hujjika1099-glitch/Repo/reports/final_release/TICKET_028_FINAL_PROJECT_CLOSURE_SUMMARY.md

# TICKET 028 - Final Project Closure Summary

## Fecha

2026-05-11

## Commit base

`032a3fb`

## Decision final

- `PROJECT_FUNCTIONAL_COMPLETE = YES`
- `PROTOTYPE_RELEASE_CANDIDATE_READY = YES`
- `BAQUELADA_REVA_FUNCTIONAL_VALIDATED_BY_EXPERT = YES`
- `BAQUELADA_REVA_ACCEPTED_FOR_PROTOTYPE_USE = YES`
- `PRODUCTION_MANUFACTURING_PACKAGE_READY = NO`
- `REPOSITORY_FINAL_STATE_READY = YES`

## Cambios realizados

- README y AGENTS actualizados al estado final.
- Node map actualizado a release candidate funcional.
- Configuracion RevA actualizada a validacion funcional experta.
- Decisiones fisicas cerradas para uso de prototipo RevA por validacion experta.
- Config final del proyecto creada.
- Documentos finales de cierre, release candidate y handover creados.
- Documentacion tecnica, cliente y baquelada actualizada.
- Validador final creado.

## Baquelada RevA

- Estado: `functional_validated_by_expert`.
- Uso: aceptada para prototipo.
- Rol: nodo sensor KX134 repetido para Sensor 1 y Sensor 2.
- Receptor: sin baquelada, conectado directamente al PC.
- Artefactos registrados: PDF y SVG bajo `hardware/pcb/baquelada_revA/artifacts/`.

## Alcance de manufactura

El prototipo funcional queda cerrado. La fabricacion industrial repetible no se
declara lista porque requeriria DFM, BOM final, Gerbers, fixture y QA de
manufactura si el cliente lo solicita.

## Advertencias no bloqueantes

- Icono corporativo pendiente.
- Firma digital pendiente.
- Scaling Windows 125/150 pendiente.
- `sample_rate_hz` GUI -> firmware pendiente.
- DFM/BOM/Gerbers/QA pendientes solo si se requiere fabricacion repetible.

## Validaciones ejecutadas

- `python -m py_compile tools\kx134\validate_final_project_state.py`
- `python tools\kx134\validate_final_project_state.py --output reports\final_release\TICKET_028_final_project_state_output.json` -> PASS
- JSON tool sobre configs y output final.
- Unit tests KX134 y app launcher.
- Verificaciones git de rutas restringidas.

## Referencias historicas restantes

La busqueda de estado anterior conserva referencias en documentos historicos de
tickets previos y en documentos no editados en TICKET 028. No aparecen como
estado actual en README, AGENTS, node_map, config final, docs finales ni docs de
baquelada actualizados.
