hujjika1099-glitch/Repo/docs/kx134_migration/REQUIREMENTS_BASELINE.md

# Baseline de requisitos KX134

## Sensores y identidad

- El sistema debe trabajar con dos sensores SparkFun SEN-17589 / KX134.
- El sistema debe usar tres ESP32 totales:
  - ESP32 sensora 1.
  - ESP32 sensora 2.
  - ESP32 receptora.
- Cada ESP32 sensora debe tener un solo SEN-17589/KX134 asociado.
- `sensor_id=1` y `sensor_id=2` son obligatorios.
- No se debe inferir `sensor_id` por defecto si falta en el stream.
- Cada sensor fisico debe tener asociacion estable:
  - `sensor_id` logico.
  - Etiqueta fisica visible.
  - ESP32 asociada.
  - MAC de la ESP32.
  - Rol dentro del sistema.
  - Archivo de calibracion individual.

## Calibracion

- La calibracion individual es obligatoria antes de pruebas de prototipo.
- Cada sensor debe tener su propio `calibration_id`.
- No se debe reutilizar calibracion entre sensores.

## Datos KX134

- Exportar datos crudos digitales por eje:
  - `x_raw`
  - `y_raw`
  - `z_raw`
- Exportar conversion basica a `g`:
  - `x_g`
  - `y_g`
  - `z_g`
- No incluir columnas de voltaje para KX134:
  - No `mv_x`
  - No `mv_y`
  - No `mv_z`
- La aplicacion no debe hacer analisis profundo. Debe capturar, convertir
  basicamente a `g`, prechequear integridad y exportar evidencia.

## Captura y sincronizacion

- La sincronizacion entre ambos sensores es requisito central.
- Debe existir precheck dual antes de aceptar capturas operativas.
- Los archivos futuros deben incluir campos de sincronizacion:
  - `sensor_id`
  - `node_mac`
  - `seq`
  - `sensor_t_us`
  - `receiver_t_us`
  - `pc_wall_s`
  - `sample_rate_hz`
  - `range_g`
  - `calibration_id`

## Parametros operativos futuros

- La duracion de captura debe ser editable manualmente en segundos.
- La duracion debe aceptar valores positivos arbitrarios, por ejemplo `10` o
  `1567`.
- La frecuencia de muestreo debe ser seleccionable.
- Frecuencias permitidas:
  - `100 Hz`
  - `200 Hz`
  - `400 Hz`
  - `800 Hz`
- La frecuencia default debe ser `100 Hz`.
- La opcion `800 Hz` debe validarse en firmware/libreria KX134 y puede
  requerir modo High-Performance.

## GUI y empaquetado futuros

- La GUI debe ser adaptable, profesional y clara para captura dual.
- La GUI debe exponer duracion manual y frecuencia seleccionable.
- El empaquetado Windows debe conservar la ruta de salida junto al ejecutable.
- El empaquetado Windows debe incorporar DPI awareness en tickets posteriores.

## Topologia base

- Arquitectura cerrada:
  - Dos ESP32 sensoras independientes.
  - Una ESP32 receptora.
  - Dos sensores SEN-17589/KX134.
  - Un KX134 por ESP32 sensora.
- La comunicacion de nodos sensores a receptor sera ESP-NOW.
- La ESP32 receptora enviara datos a la aplicacion por Serial USB.
- Esta arquitectura conserva el flujo conceptual actual del repositorio:
  nodos sensores -> ESP-NOW -> receptor -> Serial USB -> aplicacion.
- No se usara arquitectura de solo dos ESP32 ni una sola ESP32 leyendo dos
  sensores en esta fase, salvo decision futura explicita.
