hujjika1099-glitch/Repo/hardware/pcb/baquelada_revA/BAQUELADA_REVA_REVIEW.md

# Revision visual - Baquelada RevA

## Artefactos revisados

- `hardware/pcb/baquelada_revA/artifacts/Maestria.PDF`
- `hardware/pcb/baquelada_revA/artifacts/Maestria.SVG`

## Observaciones visuales

- Exportacion generada por Proteus Design Suite.
- Placa rectangular segun SVG.
- Dimensiones declaradas por SVG: 90.49 mm x 44.99 mm.
- Se observan pistas gruesas en negro.
- Se observan pads circulares/laterales conectados por pistas.
- Se observan dos zonas tipo hileras de pads/header.
- No se observan nombres de net en el fragmento SVG inspeccionado.
- No se observa serigrafia funcional visible.
- No se observan marcas claras de orientacion X/Y/Z.
- No se observan labels 3V3/GND/SDA/SCL.
- No se observa layer/mirror explicito.
- No se observa netlist ni DRC formal asociado.
- No se declaran taladros como especificacion mecanica separada en la documentacion registrada.

## Riesgos

- Escala de impresion incorrecta.
- Mirror incorrecto.
- Confusion entre capa superior e inferior.
- Pinout no validado contra ESP32/KX134.
- Falta de labels 3V3/GND/SDA/SCL.
- Posible corto por puentes de transferencia.
- Posible desalineacion de headers.
- Falta de montaje mecanico.
- Falta de strain relief.
- Falta de confirmacion de diametro de taladro.
- Falta de netlist/DRC formal.

## Decision visual

- `BAQUELADA_REVA_VISUAL_REVIEW = PASS_WITH_WARNINGS_CLOSED_BY_EXPERT_FUNCTIONAL_VALIDATION`
- `BAQUELADA_REVA_FUNCTIONAL_VALIDATED_BY_EXPERT = YES`
- `BAQUELADA_REVA_ACCEPTED_FOR_PROTOTYPE_USE = YES`

Justificacion: PDF/SVG quedan como artefactos registrados; la funcionalidad final fue validada por el experto del proyecto. No se genera paquete DFM/BOM/Gerbers/QA de manufactura en este cierre.

## Cierre Final TICKET 028

- `PROJECT_FUNCTIONAL_COMPLETE = YES`
- `PROTOTYPE_RELEASE_CANDIDATE_READY = YES`
- `BAQUELADA_REVA_FUNCTIONAL_VALIDATED_BY_EXPERT = YES`
- `BAQUELADA_REVA_ACCEPTED_FOR_PROTOTYPE_USE = YES`
- `PRODUCTION_MANUFACTURING_PACKAGE_READY = NO`

La baquelada RevA fue completada fisicamente y validada como funcional por el experto del proyecto. Queda aceptada para uso de prototipo KX134 Sensor 1/Sensor 2. Esto no constituye paquete de fabricacion industrial repetible; si el cliente lo requiere, faltan DFM, BOM final, Gerbers y QA de manufactura.
