hujjika1099-glitch/Repo/docs/kx134_migration/pcb/PCB_PRE_DESIGN_REVIEW.md

# Revision previa antes de esquematico/layout PCB KX134

No iniciar esquematico, layout, Gerber ni BOM final hasta cerrar esta lista.

- [ ] Alimentacion final cerrada.
- [ ] Tension/corriente cerradas.
- [ ] Proteccion contra inversion/sobrecorriente definida.
- [ ] Conectores cerrados.
- [ ] Longitudes cerradas.
- [ ] Tipo de cable cerrado.
- [ ] Alivio de tension definido.
- [ ] Montaje cerrado.
- [ ] Orientacion de ejes cerrada.
- [ ] Ubicacion receptor cerrada.
- [ ] Ubicacion Sensor 1 cerrada.
- [ ] Ubicacion Sensor 2 cerrada.
- [ ] Caja/carcasa definida.
- [ ] Acceso a USB/BOOT/EN definido.
- [ ] Etiquetas fisicas definidas.
- [ ] Recalibracion prevista si cambia fisica.
- [ ] Cliente aprueba dimensiones.
- [ ] Cliente aprueba cableado.
- [ ] Cliente aprueba estetica.
- [ ] Validar si se mantiene 100 Hz / 8 g.
- [ ] Validar si se requiere 200/400/800 Hz.
- [ ] Validar si se requiere configuracion `sample_rate_hz` desde GUI.

## Decision actual

- `PCB_PHYSICAL_DECISIONS_COMPLETE = NO`
- `PCB_DESIGN_AUTHORIZED = NO`
