hujjika1099-glitch/Repo/reports/kx134_gui_validation/TICKET_016_hw_capture_20260510_123052/reports/analysis_outputs/kx134_dual_live/kx134_dual_live_ticket016_hw_gui_20260510_123340_summary.md

# KX134 dual live session summary

- session_name: `ticket016_hw_gui`
- protocol_version: `kx134.v3`
- expected_sample_rate_hz: `100`
- total_samples: `0`
- invalid_lines: `0`
- samples_by_sensor: `{'1': 0, '2': 0}`
- seq_gaps_by_sensor: `{'1': 0, '2': 0}`
- effective_hz_by_sensor: `{'1': 0.0, '2': 0.0}`
- duplicate_keys_by_sensor: `{'1': 0, '2': 0}`
- warnings: `[]`
