hujjika1099-glitch/Repo/reports/kx134_gui_validation/TICKET_016_hw_capture_20260510_124537/reports/analysis_outputs/kx134_dual_live/kx134_dual_live_ticket016_hw_gui_20260510_124627_summary.md

# KX134 dual live session summary

- session_name: `ticket016_hw_gui`
- protocol_version: `kx134.v3`
- expected_sample_rate_hz: `100`
- total_samples: `2000`
- invalid_lines: `0`
- samples_by_sensor: `{'1': 1001, '2': 999}`
- seq_gaps_by_sensor: `{'1': 0, '2': 0}`
- effective_hz_by_sensor: `{'1': 100.0, '2': 100.00002004008418}`
- duplicate_keys_by_sensor: `{'1': 0, '2': 0}`
- warnings: `[]`
