hujjika1099-glitch/Repo/docs/kx134_migration/TICKET_BACKLOG.md

# Backlog de migracion KX134

## Tickets completados

- TICKET 001: COMPLETADO - Crear rama de migracion KX134 y baseline documental.
- TICKET 002: COMPLETADO - Auditoria tecnica del repositorio actual antes de migracion KX134/SEN-17589.
- TICKET 003: COMPLETADO - Contrato de datos KX134 v3.
- TICKET 004: COMPLETADO - Cerrar arquitectura fisica KX134 con tres ESP32.
- TICKET 005: COMPLETADO - Ajustar ODR KX134 a 100, 200, 400 y 800 Hz.
- TICKET 006: COMPLETADO - Firmware minimo KX134 para una ESP32 sensora por I2C/Qwiic.
- TICKET 007: COMPLETADO - Cableado KX134 I2C y helpers PlatformIO Windows.
- TICKET 008: COMPLETADO - Prueba fisica de KX134 Sensor 1, upload y captura Serial.
- TICKET 009: COMPLETADO - Calibracion interactiva de seis posiciones para KX134 Sensor 1.
- TICKET 010: COMPLETADO - Preparar firmware y prueba fisica para KX134 Sensor 2.
- TICKET 011: COMPLETADO - Generalizar herramienta y calibrar KX134 Sensor 2.
- TICKET 012: COMPLETADO - Capturar MAC de ESP32 receptora KX134 y cerrar node_map.
- TICKET 013: COMPLETADO - Firmware ESP-NOW KX134 dual: dos nodos sensores hacia receptor Serial.
- TICKET 014: COMPLETADO - Precheck de sincronizacion dual KX134 y diagnostico de duplicados.
- TICKET 015: COMPLETADO - Integrar stream Serial KX134 v3 en la GUI/core sin alterar flujo historico ADXL335.
- TICKET 016: COMPLETADO - Validacion GUI KX134 con hardware real y exportacion de sesion.
- TICKET 017: COMPLETADO - Endurecer exportacion KX134, metadata y validadores de sesion.
- TICKET 018: COMPLETADO - Rediseno visual profesional y responsive de GUI KX134/ADXL sin empaquetar.
- TICKET 019: COMPLETADO - Graficas en vivo KX134 para retroalimentacion durante captura.
- TICKET 020: COMPLETADO - Empaquetado Windows profesional KX134/ADXL con DPI awareness y validacion del ejecutable.
- TICKET 021: COMPLETADO - QA externo visual/manual del ejecutable Windows.
- TICKET 022: COMPLETADO - Validacion de prototipo con sesion controlada y criterios para entrega/baquelada.
- TICKET 023: COMPLETADO - Consolidar entrega tecnica del prototipo y documentacion final para cliente.
- TICKET 024: COMPLETADO - Documentacion de usuario/cliente y guia de operacion.
- TICKET 025: COMPLETADO DOCUMENTALMENTE - Definicion fisica preliminar para PCB/baquelada; el estado historico fue reemplazado por la validacion funcional experta de RevA en TICKET 028.
- TICKET 026: COMPLETADO - Registrar y auditar baquela/PCB RevA antes de pruebas electricas.
- TICKET 027: COMPLETADO - Limpieza, documentacion profesional y readiness de repositorio KX134; screenshots GUI quedan pendientes como mejora no bloqueante.
- TICKET 028: COMPLETADO - Cierre final del proyecto KX134 con baquelada RevA funcional validada por experto y release candidate tecnico.
- TICKET 029: COMPLETADO - Limpieza final de referencias historicas obsoletas en documentacion cliente, estado tecnico y reportes finales.

## Tickets en curso o pendientes

- Ninguno activo.

## Estado final del proyecto

- Proyecto funcional completo: YES.
- Release candidate tecnico: YES.
- Baquelada RevA funcional validada por experto: YES.
- Baquelada RevA aceptada para uso de prototipo: YES.
- Fabricacion industrial repetible: pendiente solo si el cliente requiere DFM/BOM/Gerbers/QA.

## Tickets futuros opcionales

- FUTURO OPCIONAL: Icono corporativo.
- FUTURO OPCIONAL: Firma digital.
- FUTURO OPCIONAL: QA visual scaling Windows 125/150.
- FUTURO OPCIONAL: Envio de configuracion `sample_rate_hz` desde GUI a firmware.
- FUTURO OPCIONAL: Paquete DFM/BOM/Gerbers/QA si se requiere fabricacion repetible.
- FUTURO OPCIONAL: Manual PDF si se requiere entrega formal en PDF.
- FUTURO: Icono corporativo y firma digital si se requiere.
- FUTURO: Validacion hardware en PC externo si el cliente lo requiere.
- FUTURO: Probar scaling Windows 125/150%.
- FUTURO: Envio de configuracion `sample_rate_hz` al firmware si se decide implementarlo.

## Dependencias de trabajo

- TICKET 013 debe conservar dos ESP32 sensoras y una ESP32 receptora.
- TICKET 014 valido timestamps, campos de identidad y filtro acotado de duplicados en receptor.
- TICKET 015 agrego parser/core/GUI KX134 separado y replay con log real.
- TICKET 016 valido captura/exportacion GUI KX134 con hardware real; detecto necesidad de warmup serial al abrir COM4 y `pc_wall_s` de alta resolucion.
- TICKET 017 endurecio metadata, summary y validador de bundle KX134; los bundles previos pueden quedar como metadata legacy.
- TICKET 018 agrego launcher, tema compartido, componentes responsive y smoke visual sin hardware.
- TICKET 019 agrego graficas live KX134 con Canvas, eventos de progreso del core, buffer visual por sensor y validacion manual satisfactoria con hardware.
- TICKET 020 preparo PyInstaller onedir con launcher frozen-aware, manifest DPI, smoke del exe y validador de paquete; `dist/`, `build_work/`, `.venv`, `.exe` y `.zip` quedan como artefactos locales no commiteados.
- TICKET 021 agrega checklist, script PowerShell y validador Python para QA externo; TICKET 021B cierra la validacion visual/manual externa con decision `READY_FOR_CLIENT_PROTOTYPE_QA=YES`. La captura hardware externa no se ejecuto y queda documentada como advertencia no bloqueante porque la captura hardware ya fue validada en el PC de desarrollo.
- TICKET 022 valida una sesion controlada de prototipo de 60 s en `COM4` con Sensor 1 `5998` filas y Sensor 2 `6000` filas. La validacion de prototipo pasa con advertencia por `2` seq gaps en Sensor 1 y `READY_FOR_PROTOTYPE_DELIVERY=YES`. La autorizacion fisica RevA fue cerrada posteriormente por validacion experta en TICKET 028.
- TICKET 023 consolida el paquete documental de entrega del prototipo y corrige la semantica de recomendacion PCB. El estado final vigente queda reemplazado por TICKET 028: RevA funcional para prototipo y manufactura industrial pendiente solo si se solicita.
- TICKET 024 agrega documentacion cliente para instalacion Windows, conexion hardware, operacion KX134, graficas live, exportacion CSV/JSON/summary, troubleshooting, manifiesto, checklists y limitaciones. La decision queda `CLIENT_USER_DOCS_READY=YES`.
- TICKET 025 crea formulario, especificacion fisica preliminar, matriz de decisiones, checklist de riesgos, pre-design review, JSON documental y validador para decisiones fisicas PCB. Ese fue el estado documental previo; TICKET 028 cierra el uso de RevA para prototipo mediante validacion funcional experta.
- TICKET 026 registra la baquelada RevA creada externamente en Proteus con artefactos `Maestria.PDF` y `Maestria.SVG`, detecta dimensiones SVG `90.49 mm x 44.99 mm`, documenta revision visual `PASS_WITH_WARNINGS`, checklist de continuidad, pinout pendiente y plan de prueba. Ese fue el estado anterior de revision documental; TICKET 028 lo reemplaza con validacion funcional experta y aceptacion para prototipo.
- TICKET 027 profesionaliza README, AGENTS, indices tecnicos, diagramas, mantenimiento, estado del repositorio y validador documental. El sistema principal queda documentado como KX134 dual; ADXL335 queda preservado como legacy. La responsabilidad fisica experta de RevA queda cerrada posteriormente en TICKET 028.
- TICKET 028 incorpora el reporte del usuario experto: la baquelada RevA fue completada fisicamente y quedo totalmente funcional. Se acepta para uso de prototipo Sensor 1/Sensor 2, se cierra el proyecto como prototipo KX134 funcional y release candidate tecnico. La fabricacion industrial repetible queda fuera de alcance salvo solicitud de paquete DFM/BOM/Gerbers/QA.
- TICKET 029 limpia referencias de estado anterior en documentacion cliente/tecnica vigente y deja como permitidas solo las referencias historicas contextualizadas de tickets previos.

## Regla de alcance

Este backlog enumera trabajo futuro. Ninguno de los tickets futuros queda implementado
por la validacion dual de TICKET 013.
