hujjika1099-glitch/Repo/docs/kx134_migration/FINAL_HANDOVER_CHECKLIST.md

# Checklist final de entrega

## Hardware

- [x] Sensor 1 KX134 identificado.
- [x] Sensor 2 KX134 identificado.
- [x] Receptor ESP32 identificado.
- [x] Baquelada RevA funcional validada por experto.
- [x] Receptor directo al PC sin baquelada.

## Software

- [x] Ejecutable Windows preparado.
- [x] Launcher principal disponible.
- [x] GUI KX134 disponible.
- [x] GUI ADXL335 preservada como legacy.
- [x] Exportacion KX134 validada.

## Documentacion

- [x] README principal actualizado.
- [x] AGENTS actualizado.
- [x] Documentacion cliente lista.
- [x] Estado final documentado.
- [x] Release candidate documentado.
- [x] Backlog actualizado.

## Configuracion

- [x] `config/kx134_node_map.json`.
- [x] `config/kx134_project_final_status.json`.
- [x] Calibraciones Sensor 1/Sensor 2 preservadas.
- [x] Contrato KX134 v3 preservado.

## Pendientes opcionales

- [ ] Icono corporativo.
- [ ] Firma digital.
- [ ] QA scaling 125/150.
- [ ] Comando `sample_rate_hz` GUI -> firmware.
- [ ] Paquete DFM/BOM/Gerbers/QA si se requiere fabricacion repetible.
