hujjika1099-glitch/Repo/docs/kx134_migration/PROJECT_FINAL_STATUS.md

# Estado final del proyecto KX134

## Decision final

- `PROJECT_FUNCTIONAL_COMPLETE = YES`
- `PROTOTYPE_RELEASE_CANDIDATE_READY = YES`
- `BAQUELADA_REVA_FUNCTIONAL_VALIDATED_BY_EXPERT = YES`
- `BAQUELADA_REVA_ACCEPTED_FOR_PROTOTYPE_USE = YES`
- `REPOSITORY_FINAL_STATE_READY = YES`
- `PRODUCTION_MANUFACTURING_PACKAGE_READY = NO`

## Que esta completo

- Dos sensores SEN-17589/KX134 calibrados y validados.
- Dos ESP32 sensoras identificadas.
- Una ESP32 receptora identificada.
- Firmware KX134 dual ESP-NOW validado.
- Receptor ESP-NOW a Serial USB validado.
- GUI KX134 validada con hardware real.
- Graficas live validadas.
- Exportacion CSV/JSON/summary KX134 v3 validada.
- Ejecutable Windows preparado como `Sistema_Captura_Acelerometria.exe`.
- Documentacion cliente lista.
- Baquelada RevA funcional validada por experto y aceptada para uso de prototipo.

## Que queda opcional

- Icono corporativo.
- Firma digital del ejecutable.
- QA visual en scaling Windows 125/150.
- Comando `sample_rate_hz` desde GUI hacia firmware.
- Paquete DFM/BOM/Gerbers/QA si se requiere fabricacion repetible.
- Manual PDF si se solicita entrega formal en PDF.

## Que no esta autorizado como produccion masiva

La RevA funcional valida el prototipo. No se declara producto comercial ni
fabricacion industrial repetible porque no se genero paquete DFM, BOM final,
Gerbers finales, fixture de produccion ni plan QA de manufactura.

## Configuracion validada

- `sample_rate_hz`: 100.
- `odr_hz`: 100.
- `range_g`: 8.
- Baudrate: 921600.
- ESP-NOW channel: 1.
- Sensor 1 MAC: `D4:E9:F4:E9:8E:1C`.
- Sensor 2 MAC: `D4:E9:F4:C3:37:14`.
- Receptor MAC: `00:4B:12:96:9A:80`.

## Evidencia principal

- `reports/kx134_gui_validation/TICKET_016_GUI_HARDWARE_VALIDATION_SUMMARY.md`
- `reports/kx134_gui_validation/TICKET_019_GUI_LIVE_PLOTS_SUMMARY.md`
- `reports/kx134_gui_validation/TICKET_020_WINDOWS_PACKAGING_SUMMARY.md`
- `reports/prototype_validation/TICKET_022_PROTOTYPE_VALIDATION_SUMMARY.md`
- `reports/prototype_validation/TICKET_026_BAQUELADA_REVA_REVIEW_SUMMARY.md`
- `reports/final_release/TICKET_028_FINAL_PROJECT_CLOSURE_SUMMARY.md`
