hujjika1099-glitch/Repo/docs/kx134_migration/REPOSITORY_STATUS.md

# Estado Del Repositorio

## Decision Actual

- `PROTOTYPE_DELIVERY_PACKAGE_READY = YES`
- `CLIENT_USER_DOCS_READY = YES`
- `PROTOTYPE_PCB_REVA_AUTHORIZED_FOR_USE = YES`; `PRODUCTION_MANUFACTURING_PACKAGE_READY = NO`
- `BAQUELADA_REVA_ACCEPTED_FOR_PROTOTYPE_USE = YES`
- `REPOSITORY_FINAL_STATE_READY = YES`

## Estado Operativo

El flujo principal actual es KX134 dual. La captura con hardware real, la
exportacion, las graficas live, el empaquetado Windows y la QA visual externa
estan documentados y validados.

ADXL335 se conserva como legacy/historico y no debe confundirse con el flujo
principal.

## Baquelada RevA

La baquelada RevA creada en Proteus esta registrada bajo
`hardware/pcb/baquelada_revA/`. Su estado actual es `functional_validated_by_expert`; esta aceptada para uso de prototipo. La fabricacion industrial repetible requiere paquete DFM/BOM/Gerbers/QA si se solicita.

## Pendientes

- Screenshots GUI completos.
- Icono corporativo.
- Firma digital.
- QA visual scaling 125/150.
- Configuracion remota `sample_rate_hz` desde GUI hacia firmware.
- Paquete DFM/BOM/Gerbers/QA si se requiere fabricacion repetible.
- Decisiones fisicas de PCB: alimentacion, conectores, cableado, montaje,
  orientacion y ubicaciones finales.

## Cierre Final TICKET 028

- `PROJECT_FUNCTIONAL_COMPLETE = YES`
- `PROTOTYPE_RELEASE_CANDIDATE_READY = YES`
- `BAQUELADA_REVA_FUNCTIONAL_VALIDATED_BY_EXPERT = YES`
- `BAQUELADA_REVA_ACCEPTED_FOR_PROTOTYPE_USE = YES`
- `PRODUCTION_MANUFACTURING_PACKAGE_READY = NO`

La baquelada RevA fue completada fisicamente y validada como funcional por el experto del proyecto. Queda aceptada para uso de prototipo KX134 Sensor 1/Sensor 2. Esto no constituye paquete de fabricacion industrial repetible; si el cliente lo requiere, faltan DFM, BOM final, Gerbers y QA de manufactura.
