hujjika1099-glitch/Repo/docs/kx134_migration/tickets/TICKET_028_FINAL_PROJECT_CLOSURE.md

# TICKET 028 - Cierre final del proyecto KX134

## Objetivo

Cerrar documentalmente el proyecto como prototipo funcional KX134 con baquelada
RevA funcional validada por experto y release candidate tecnico listo.

## Precondiciones

- Firmware KX134 dual validado.
- GUI KX134 validada con hardware real.
- Graficas live validadas.
- Exportacion CSV/JSON/summary validada.
- Ejecutable Windows preparado.
- Documentacion cliente lista.
- Baquelada RevA registrada previamente.
- Usuario experto informa que la baquelada fue completada y quedo funcional.

## Actualizacion de baquelada

- Estado anterior: revision documental y artefactos PDF/SVG registrados.
- Estado final: `functional_validated_by_expert`.
- Aceptada para uso de prototipo: YES.
- Autoridad de validacion: `project_expert_user`.
- Alcance: prototipo RevA para nodos sensores KX134 Sensor 1 y Sensor 2.
- Receptor: sin baquelada, conectado directamente al PC.

## Actualizacion de repositorio

Se actualizan README, AGENTS, documentacion tecnica, documentacion cliente,
documentacion de baquelada, configuraciones de estado, validador final, reporte
final, backlog y change log.

## Decisiones finales

- `PROJECT_FUNCTIONAL_COMPLETE = YES`
- `PROTOTYPE_RELEASE_CANDIDATE_READY = YES`
- `BAQUELADA_REVA_FUNCTIONAL_VALIDATED_BY_EXPERT = YES`
- `BAQUELADA_REVA_ACCEPTED_FOR_PROTOTYPE_USE = YES`
- `PRODUCTION_MANUFACTURING_PACKAGE_READY = NO`

## Restricciones

No se modifica firmware, GUI funcional, calibraciones, empaquetado, data
historica, binarios, Gerbers, BOM ni archivos de fabricacion final.

## Resultado

El repositorio queda listo como cierre funcional del prototipo KX134. La
produccion industrial repetible queda fuera de alcance y requiere paquete
adicional si el cliente la solicita.
