hujjika1099-glitch/Repo/docs/kx134_migration/tickets/TICKET_025_PCB_PHYSICAL_DEFINITION.md

# TICKET 025 - Definicion fisica para PCB/baquelada

## Objetivo

Registrar las decisiones fisicas requeridas antes de iniciar diseno de PCB/baquelada para el sistema KX134 dual.

## Precondiciones

- TICKET 024 aprobado.
- `CLIENT_USER_DOCS_READY = YES`.
- `PROTOTYPE_DELIVERY_PACKAGE_READY = YES`.
- `PCB_DESIGN_AUTHORIZED = NO`.
- Estado previo: `client_documentation_ready_prototype_ready_pcb_blocked`.

## Preguntas realizadas

Se preparo la ronda de preguntas sobre:

- alimentacion;
- conectores;
- cableado;
- montaje;
- orientacion;
- receptor;
- ambiente;
- restricciones del cliente.

En esta ejecucion no hubo respuestas cerradas para las decisiones criticas. Por regla del proyecto, las respuestas no confirmadas se registran como `PENDING`.

## Archivos generados

- `docs/kx134_migration/pcb/PCB_PHYSICAL_DECISION_FORM.md`
- `docs/kx134_migration/pcb/PCB_PHYSICAL_DESIGN_SPEC.md`
- `docs/kx134_migration/pcb/PCB_DECISION_MATRIX.md`
- `docs/kx134_migration/pcb/PCB_RISK_CHECKLIST.md`
- `docs/kx134_migration/pcb/PCB_PRE_DESIGN_REVIEW.md`
- `config/kx134_physical_design_decisions.json`
- `tools/kx134/validate_pcb_physical_decisions.py`
- `reports/prototype_validation/TICKET_025_PCB_PHYSICAL_DEFINITION_SUMMARY.md`
- `reports/prototype_validation/TICKET_025_pcb_physical_decisions_output.json`

## Criterios de autorizacion PCB

PCB solo se autoriza si:

- `pcb_physical_decisions_complete=true`;
- `critical_blockers=[]`;
- alimentacion cerrada;
- conectores cerrados;
- cableado cerrado;
- montaje cerrado;
- orientacion cerrada;
- ubicacion de receptor y sensores cerrada;
- restricciones cliente cerradas.

## Resultado

- `PCB_PHYSICAL_DECISIONS_COMPLETE = NO`
- `PCB_DESIGN_AUTHORIZED = NO`

## Restricciones

- Firmware no modificado.
- GUI no modificada.
- Calibraciones no modificadas.
- Empaquetado no modificado.
- Data historica no modificada.
- No se crearon esquematicos, layouts, Gerber ni BOM final.
