hujjika1099-glitch/Repo/docs/kx134_migration/tickets/TICKET_024_CLIENT_USER_DOCUMENTATION.md

# TICKET 024 - Documentacion de usuario/cliente KX134

## Objetivo

Crear documentacion orientada a usuario/cliente para operar el prototipo KX134 dual: instalacion Windows, conexion hardware, captura, graficas, exportacion, interpretacion de archivos, troubleshooting, checklists y advertencias.

## Precondiciones

- TICKET 023 aprobado.
- `PROTOTYPE_DELIVERY_PACKAGE_READY = YES`.
- `PCB_DESIGN_AUTHORIZED = NO`.
- Prototipo KX134 dual validado con sesion controlada.
- Ejecutable Windows preparado y QA visual externa aprobada.

## Documentos generados

- `docs/kx134_migration/client/QUICK_START_GUIDE.md`
- `docs/kx134_migration/client/USER_MANUAL_KX134_PROTOTYPE.md`
- `docs/kx134_migration/client/WINDOWS_INSTALLATION_GUIDE.md`
- `docs/kx134_migration/client/HARDWARE_CONNECTION_GUIDE.md`
- `docs/kx134_migration/client/CAPTURE_AND_EXPORT_GUIDE.md`
- `docs/kx134_migration/client/OUTPUT_FILES_REFERENCE.md`
- `docs/kx134_migration/client/TROUBLESHOOTING_GUIDE.md`
- `docs/kx134_migration/client/RELEASE_NOTES_PROTOTYPE.md`
- `docs/kx134_migration/client/DELIVERY_MANIFEST.md`
- `docs/kx134_migration/client/PRE_TEST_CHECKLIST.md`
- `docs/kx134_migration/client/POST_TEST_CHECKLIST.md`
- `docs/kx134_migration/client/LIMITATIONS_AND_WARNINGS.md`

## Validacion documental

Se agrega `tools/kx134/validate_client_docs.py` para verificar existencia de documentos, terminos obligatorios, ausencia de contradiccion PCB y presencia de advertencias sobre `sample_rate_hz`, `range_g` y recalibracion.

## Restricciones

- Firmware no modificado.
- GUI no modificada.
- Calibraciones no modificadas.
- Empaquetado no modificado.
- Data historica no modificada.
- No se crea PDF ni instalador.

## Decision final

- `CLIENT_USER_DOCS_READY = YES` si el validador documental pasa.
- `PCB_DESIGN_AUTHORIZED = NO`.

## Siguiente ticket recomendado

TICKET 025 - Definicion fisica para PCB/baquelada: alimentacion, conectores, montaje y orientacion.
