hujjika1099-glitch/Repo/docs/kx134_migration/tickets/TICKET_023_PROTOTYPE_DELIVERY_PACKAGE.md

# TICKET 023 - Paquete de entrega tecnica del prototipo

## Objetivo

Consolidar el estado tecnico del prototipo KX134 dual, preparar la documentacion final de entrega tecnica y corregir la semantica de recomendacion PCB detectada en el output historico de TICKET 022.

## Precondiciones

- TICKET 022 aprobado.
- `READY_FOR_PROTOTYPE_DELIVERY = YES`.
- `READY_FOR_PCB_DESIGN = NO`.
- Sesion controlada de 60 s validada.
- QA visual externa aprobada.
- Captura hardware real validada previamente en PC de desarrollo.

## Cambios documentales

- Se crea paquete de entrega tecnica.
- Se crea resumen tecnico del sistema.
- Se crea matriz de evidencias.
- Se crea registro de pendientes y riesgos.
- Se crea reporte final de entrega.

## Correccion semantica PCB

El output historico `reports/prototype_validation/TICKET_022_prototype_validation_output.json` indicaba `ready_for_pcb_design_recommendation=true` porque evaluaba solo la calidad tecnica de la captura.

La semantica corregida distingue:

- `ready_for_pcb_design_technical_capture_recommendation = true`
- `ready_for_pcb_design_final_recommendation = false`

La recomendacion final de PCB queda bloqueada por decisiones fisicas/mecanicas abiertas.

## Criterios de aceptacion

- Paquete documental creado.
- JSON de readiness generado.
- Correccion PCB documentada.
- `node_map` actualizado a prototipo listo / PCB bloqueada.
- Firmware, GUI, calibraciones, empaquetado y data historica sin cambios.

## Restricciones

- No modificar firmware.
- No modificar GUI.
- No modificar calibraciones.
- No modificar empaquetado.
- No iniciar diseno PCB.
- No commitear `dist/`, `build_work/`, `.venv`, `.exe` ni `.zip`.

## Decision final

- `PROTOTYPE_DELIVERY_PACKAGE_READY = YES`
- `PCB_DESIGN_AUTHORIZED = NO`
