hujjika1099-glitch/Repo/docs/assets/screenshots/README.md

# Screenshots GUI

screenshots_status = PENDING

Las capturas de GUI quedan pendientes de ejecucion interactiva. El script
`tools/kx134/capture_gui_screenshots.ps1` guia al operador para capturar:

- `launcher_main.png`
- `kx134_connection_tab.png`
- `kx134_capture_tab.png`
- `kx134_sensors_tab.png`
- `kx134_live_plots_tab.png`
- `kx134_diagnostics_tab.png`
- `kx134_export_tab.png`
- `adxl_legacy_window.png`

No se bloquea el estado documental del repositorio porque el README y los
diagramas explican el flujo sin depender de estas imagenes.
