hujjika1099-glitch/Repo/reports/toolchain_status.md

# Estado del Toolchain Local (Fase 3)

Fecha de verificacion: 2026-03-20

## Alcance de la verificacion
- Terminal integrada de VS Code en el workspace del proyecto.
- Comandos probados:
  - `pio --version`
  - `platformio --version`
  - ejecucion directa por ruta completa.

## Resultado de diagnostico
- `pio` en PATH: no disponible.
- `platformio` en PATH: no disponible.
- Ejecutables locales verificados:
  - `C:\\Users\\JOSE DAVID\\.platformio\\penv\\Scripts\\pio.exe`
  - `C:\\Users\\JOSE DAVID\\.platformio\\penv\\Scripts\\platformio.exe`
- Version reportada por ambos ejecutables:
  - `PlatformIO Core, version 6.1.11`

## Estrategia adoptada
Estrategia 2: usar ruta ejecutable local verificada.

Motivo:
- Permite tareas reales en VS Code sin depender de PATH global.
- Evita suposiciones sobre instalacion adicional.

## Implicaciones
- `.vscode/tasks.json` usa `pio.exe` por ruta local via `${env:USERPROFILE}`.
- El flujo de firmware queda habilitado a nivel de comando/tarea.
- La implementacion funcional de firmware ADXL335 se mantiene diferida.
