hujjika1099-glitch/Repo/reports/final_release/TICKET_029_STALE_REFERENCE_CLEANUP_SUMMARY.md

# TICKET 029 - Limpieza final de referencias historicas obsoletas

## Fecha

2026-05-11

## Commit base

- `5290ff9 docs: close KX134 project with functional baquelada RevA`

## Objetivo

Limpiar referencias de estado anterior en documentos actuales de usuario, operacion, entrega y estado final para evitar ambiguedad despues del cierre funcional del proyecto KX134.

## Estado vigente

- `PROJECT_FUNCTIONAL_COMPLETE = YES`
- `PROTOTYPE_RELEASE_CANDIDATE_READY = YES`
- `BAQUELADA_REVA_FUNCTIONAL_VALIDATED_BY_EXPERT = YES`
- `BAQUELADA_REVA_ACCEPTED_FOR_PROTOTYPE_USE = YES`
- `PRODUCTION_MANUFACTURING_PACKAGE_READY = NO`

## Documentos corregidos

### Cliente

- `docs/kx134_migration/client/CAPTURE_AND_EXPORT_GUIDE.md`
- `docs/kx134_migration/client/DELIVERY_MANIFEST.md`
- `docs/kx134_migration/client/HARDWARE_CONNECTION_GUIDE.md`
- `docs/kx134_migration/client/LIMITATIONS_AND_WARNINGS.md`
- `docs/kx134_migration/client/OUTPUT_FILES_REFERENCE.md`
- `docs/kx134_migration/client/PRE_TEST_CHECKLIST.md`
- `docs/kx134_migration/client/QUICK_START_GUIDE.md`
- `docs/kx134_migration/client/RELEASE_NOTES_PROTOTYPE.md`
- `docs/kx134_migration/client/TROUBLESHOOTING_GUIDE.md`
- `docs/kx134_migration/client/USER_MANUAL_KX134_PROTOTYPE.md`
- `docs/kx134_migration/client/WINDOWS_INSTALLATION_GUIDE.md`

### Estado y trazabilidad

- `docs/kx134_migration/TICKET_BACKLOG.md`
- `config/kx134_node_map.json`
- `tools/kx134/validate_final_project_state.py`

## Referencias corregidas

Se reemplazaron referencias actuales a estados anteriores de bloqueo PCB/RevA, representadas en el validador como:

- `old_pcb_design_not_authorized_flag`
- `old_pcb_not_authorized_text`
- `old_pending_physical_decisions_text`

por el estado final vigente:

- RevA funcional validada por experto.
- RevA aceptada para uso de prototipo.
- Prototipo KX134 cerrado como release candidate.
- Produccion industrial repetible pendiente solo si se solicita DFM/BOM/Gerbers/QA.

## Referencias historicas que permanecen

El validador permite referencias antiguas en:

- tickets historicos;
- documentos preliminares de PCB del TICKET 025;
- salida historica del TICKET 028.

Estas referencias no representan el estado actual y se clasifican como `historical_allowed`.

## Validacion

- `tools/kx134/validate_final_project_state.py` se actualizo para separar:
  - `blocking`;
  - `warning`;
  - `historical_allowed`.
- La salida `reports/final_release/TICKET_029_stale_reference_cleanup_output.json` pasa sin fallos ni warnings bloqueantes.
- La busqueda final sobre documentos vigentes no devuelve referencias bloqueantes.

## Decision

- `DOCUMENTATION_STALE_REFERENCES_CLEAN = YES`
- `REPOSITORY_FINAL_STATE_READY = YES`

## Restricciones

- Firmware no modificado.
- GUI no modificada.
- Calibraciones no modificadas.
- Empaquetado no modificado.
- Data historica no modificada.
- Binarios no commiteados.
