hujjika1099-glitch/Repo/reports/kx134_gui_validation/TICKET_016_hw_capture_20260510_123827/reports/analysis_outputs/kx134_dual_live/kx134_dual_live_ticket016_hw_gui_20260510_123921_summary.md

# KX134 dual live session summary

- session_name: `ticket016_hw_gui`
- protocol_version: `kx134.v3`
- expected_sample_rate_hz: `100`
- total_samples: `1913`
- invalid_lines: `1`
- samples_by_sensor: `{'1': 957, '2': 956}`
- seq_gaps_by_sensor: `{'1': 18, '2': 28}`
- effective_hz_by_sensor: `{'1': 98.15191040989305, '2': 97.1516954039008}`
- duplicate_keys_by_sensor: `{'1': 0, '2': 0}`
- warnings: `[]`
