hujjika1099-glitch/Repo/reports/kx134_gui_validation/TICKET_016_hw_capture_20260510_124056/reports/analysis_outputs/kx134_dual_live/kx134_dual_live_ticket016_hw_gui_20260510_124204_summary.md

# KX134 dual live session summary

- session_name: `ticket016_hw_gui`
- protocol_version: `kx134.v3`
- expected_sample_rate_hz: `100`
- total_samples: `2000`
- invalid_lines: `0`
- samples_by_sensor: `{'1': 1000, '2': 1000}`
- seq_gaps_by_sensor: `{'1': 0, '2': 0}`
- effective_hz_by_sensor: `{'1': 99.999949949975, '2': 100.0000500500751}`
- duplicate_keys_by_sensor: `{'1': 0, '2': 0}`
- warnings: `[]`
