hujjika1099-glitch/Repo/docs/kx134_migration/tickets/TICKET_002_AUDITORIA_TECNICA.md

# TICKET 002 - Auditoria tecnica del repositorio actual

## Objetivo

Auditar firmware, GUI, exportacion, calibracion, contratos y empaquetado actuales para
preparar la migracion ADXL335 -> KX134/SEN-17589.

## Rama

`feature/kx134-dual-capture`

## Entregables

- `docs/kx134_migration/audits/TICKET_002_REPO_AUDIT.md`
- `docs/kx134_migration/tickets/TICKET_002_AUDITORIA_TECNICA.md`
- Actualizacion de `docs/kx134_migration/TICKET_BACKLOG.md`
- Actualizacion de `reports/change_log.md`

## Restricciones

- No modificar firmware.
- No modificar GUI.
- No modificar empaquetado.
- No modificar scripts funcionales.
- No modificar datos historicos.
- No implementar KX134.
- No cambiar contratos actuales.
- No crear binarios.

## Criterios de aceptacion

- Auditoria documentada con referencias archivo:linea.
- Riesgos priorizados.
- Decisiones pendientes documentadas.
- Archivos futuros candidatos identificados.
- No hay cambios funcionales.
- Git queda limpio despues del commit.
- Rama publicada en origin si las credenciales lo permiten.

## Estado de cierre

- Estado: completado documentalmente.
- Fecha: 2026-05-08.
- Rama: `feature/kx134-dual-capture`.
- Commit base auditado: `1d31f2abe1cbbfee623ff73a3d889fc83fae98fc`.
- Cambios funcionales: ninguno.
