hujjika1099-glitch/Repo/reports/analysis_outputs/sensor_A_z_plus_static_20260320_132709_analysis_20260320_134502_raw.png

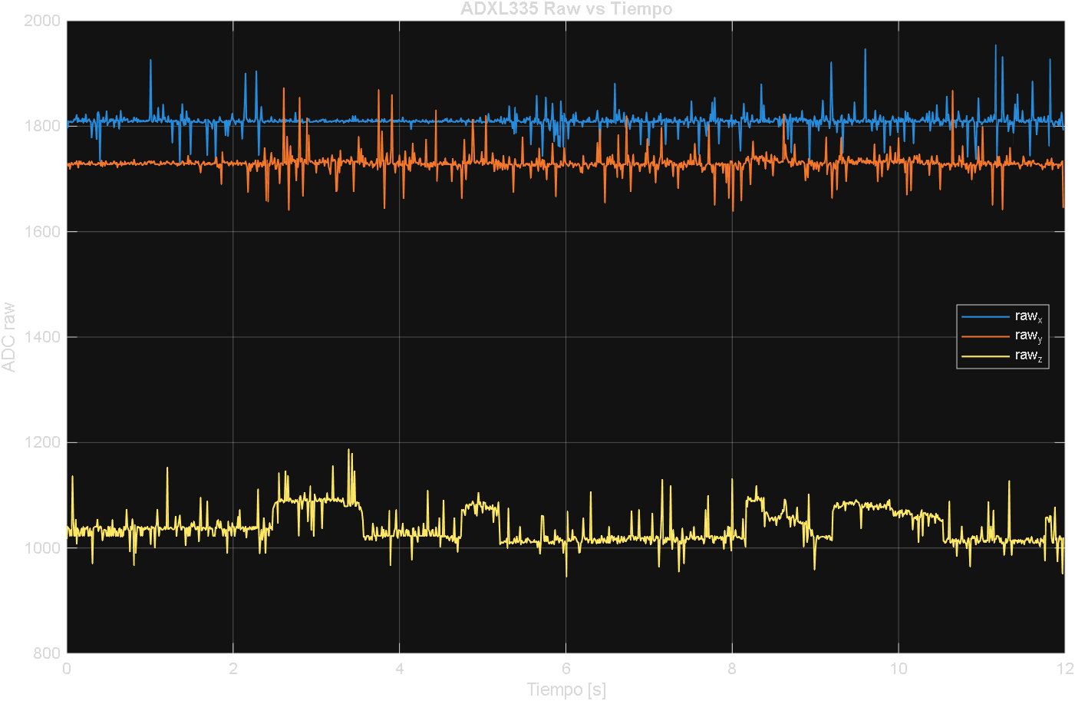
reports/analysis_outputs/sensor_A_z_plus_static_20260320_132709_analysis_20260320_134502_raw.png
