hujjika1099-glitch/Repo/docs/kx134_migration/VALIDATION_SUMMARY.md

# Resumen De Validacion KX134

## Validaciones Completadas

| Area | Evidencia | Resultado |
|---|---|---|
| Calibracion Sensor 1 | TICKET 009 | PASS |
| Calibracion Sensor 2 | TICKET 011 | PASS |
| ESP-NOW dual | TICKET 013 | PASS |
| Sync precheck dual | TICKET 014 | PASS |
| GUI hardware KX134 | TICKET 016 | PASS |
| Exportacion endurecida | TICKET 017 | PASS |
| Redisenio visual | TICKET 018 | PASS |
| Graficas live | TICKET 019 | PASS |
| Empaquetado Windows | TICKET 020 | PASS |
| QA visual externa | TICKET 021/021B | PASS |
| Sesion controlada prototipo | TICKET 022 | PASS con advertencia |
| Entrega tecnica prototipo | TICKET 023 | PASS |
| Documentacion cliente | TICKET 024 | PASS |
| Decisiones fisicas PCB | TICKET 025/028 | Cerradas para uso de prototipo por validacion experta |
| Baquelada RevA | TICKET 026/028 | Functional validated by expert |

## Sesion Controlada De Prototipo

- Duracion: 60 s.
- Sensor 1 rows: 5998.
- Sensor 2 rows: 6000.
- Effective Hz Sensor 1: 99.966656.
- Effective Hz Sensor 2: 100.000007.
- Seq gaps Sensor 1: 2, advertencia no bloqueante.
- Seq gaps Sensor 2: 0.
- Invalid lines: 0.
- Duplicate keys: 0.
- `packet_status`: OK.
- `packet_error_code`: OK.
- Campos prohibidos detectados: false.

## Decision

- `READY_FOR_PROTOTYPE_DELIVERY = YES`
- `PROTOTYPE_RELEASE_CANDIDATE_READY = YES`
- `PROTOTYPE_PCB_REVA_AUTHORIZED_FOR_USE = YES`
- `PRODUCTION_MANUFACTURING_PACKAGE_READY = NO`

La RevA queda aceptada para prototipo. La fabricacion industrial repetible queda
fuera de alcance hasta contar con DFM, BOM final, Gerbers y QA de manufactura.

## Cierre Final TICKET 028

- `PROJECT_FUNCTIONAL_COMPLETE = YES`
- `PROTOTYPE_RELEASE_CANDIDATE_READY = YES`
- `BAQUELADA_REVA_FUNCTIONAL_VALIDATED_BY_EXPERT = YES`
- `BAQUELADA_REVA_ACCEPTED_FOR_PROTOTYPE_USE = YES`
- `PRODUCTION_MANUFACTURING_PACKAGE_READY = NO`

La baquelada RevA fue completada fisicamente y validada como funcional por el experto del proyecto. Queda aceptada para uso de prototipo KX134 Sensor 1/Sensor 2. Esto no constituye paquete de fabricacion industrial repetible; si el cliente lo requiere, faltan DFM, BOM final, Gerbers y QA de manufactura.
