hujjika1099-glitch/Repo/reports/prototype_validation/TICKET_024_CLIENT_DOCUMENTATION_SUMMARY.md

# TICKET 024 - Client documentation summary

## Fecha

2026-05-10

## Commit base

`9044b6b` - docs: consolidate KX134 prototype delivery package

## Objetivo

Preparar documentacion de usuario/cliente para operar el prototipo KX134 dual sin modificar firmware, GUI, calibraciones, empaquetado ni data historica.

## Documentos creados

- `docs/kx134_migration/client/QUICK_START_GUIDE.md`
- `docs/kx134_migration/client/USER_MANUAL_KX134_PROTOTYPE.md`
- `docs/kx134_migration/client/WINDOWS_INSTALLATION_GUIDE.md`
- `docs/kx134_migration/client/HARDWARE_CONNECTION_GUIDE.md`
- `docs/kx134_migration/client/CAPTURE_AND_EXPORT_GUIDE.md`
- `docs/kx134_migration/client/OUTPUT_FILES_REFERENCE.md`
- `docs/kx134_migration/client/TROUBLESHOOTING_GUIDE.md`
- `docs/kx134_migration/client/RELEASE_NOTES_PROTOTYPE.md`
- `docs/kx134_migration/client/DELIVERY_MANIFEST.md`
- `docs/kx134_migration/client/PRE_TEST_CHECKLIST.md`
- `docs/kx134_migration/client/POST_TEST_CHECKLIST.md`
- `docs/kx134_migration/client/LIMITATIONS_AND_WARNINGS.md`
- `docs/kx134_migration/tickets/TICKET_024_CLIENT_USER_DOCUMENTATION.md`

## Validador documental

Herramienta: `tools/kx134/validate_client_docs.py`

Valida:

- existencia de documentos cliente;
- terminos minimos KX134, Sensor 1, Sensor 2, Receptor, 100 Hz, 8 g, 921600, CSV, JSON y summary;
- ausencia de contradicciones que autoricen PCB;
- presencia de `PCB_DESIGN_AUTHORIZED = NO` o equivalente;
- advertencias sobre `sample_rate_hz` pendiente, `range_g` y recalibracion.

Resultado: `pass=true`, sin documentos faltantes, sin terminos faltantes y sin contradicciones PCB.

Salida: `reports/prototype_validation/TICKET_024_client_docs_readiness_output.json`.

## Decision

- `CLIENT_USER_DOCS_READY = YES`
- `PCB_DESIGN_AUTHORIZED = NO`

## Advertencias

- PCB sigue bloqueada por decisiones fisicas/mecanicas.
- Icono corporativo pendiente.
- Firma digital pendiente.
- Scaling Windows 125/150 pendiente.
- `sample_rate_hz` desde GUI a firmware pendiente.
- Hardware externo con captura queda pendiente si el cliente lo exige.

## Restricciones verificadas

- Firmware no modificado.
- GUI no modificada.
- Calibraciones no modificadas.
- Empaquetado no modificado.
- Data historica no modificada.
- `dist/`, `build_work/`, `.exe` y `.zip` no commiteados.

## Proximo ticket recomendado

TICKET 025 - Definicion fisica para PCB/baquelada: alimentacion, conectores, montaje y orientacion.
