hujjika1099-glitch/Repo/reports/kx134_gui_validation/TICKET_015_GUI_KX134_VALIDATION_SUMMARY.md

# TICKET 015 - GUI KX134 validation

- Log usado: `C:\Users\JOSE DAVID\Desktop\-\Aplicaciones\UQ_2021_2025\AYUDA\Maestria\Repo\reports\kx134_test_runs\TICKET_014_static_receiver_monitor_20260510_112712.txt`
- Rows sensor 1: `2999`
- Rows sensor 2: `2999`
- Effective Hz sensor 1: `100.000000`
- Effective Hz sensor 2: `100.000000`
- Seq gaps sensor 1: `0`
- Seq gaps sensor 2: `0`
- Invalid lines: `0`
- Campos prohibidos: `False`
- CSV exportado: `C:\Users\JOSE DAVID\AppData\Local\Temp\kx134_ticket015_replay_2i0l6xzc\data\raw\kx134_dual_live\ticket015_replay_ticket015_static_replay_20260510_120411_raw.csv`
- Metadata JSON: `C:\Users\JOSE DAVID\AppData\Local\Temp\kx134_ticket015_replay_2i0l6xzc\data\processed\kx134_dual_live\ticket015_replay_ticket015_static_replay_20260510_120411_session.json`
- Summary: `C:\Users\JOSE DAVID\AppData\Local\Temp\kx134_ticket015_replay_2i0l6xzc\reports\analysis_outputs\kx134_dual_live\ticket015_replay_ticket015_static_replay_20260510_120411_summary.md`
- READY_FOR_GUI_HARDWARE_VALIDATION: `True`
