hujjika1099-glitch/Repo/docs/kx134_migration/client/PRE_TEST_CHECKLIST.md

# Checklist previo a prueba KX134

- [ ] Sensor 1 alimentado.
- [ ] Sensor 2 alimentado.
- [ ] Receptor conectado al PC por USB.
- [ ] Puerto COM identificado.
- [ ] Windows reconoce el USB.
- [ ] Aplicacion `Sistema_Captura_Acelerometria.exe` abre.
- [ ] KX134 Dual Capture abre.
- [ ] Baudrate configurado en `921600`.
- [ ] Duracion configurada.
- [ ] Frecuencia esperada configurada en `100 Hz`.
- [ ] `range_g` esperado: `8 g`.
- [ ] Sensor 1 visible.
- [ ] Sensor 2 visible.
- [ ] Carpeta de salida conocida.
- [ ] Prueba corta de 10 s planificada.
- [ ] Se sabe donde quedan CSV, JSON y summary.
- [ ] Se recuerda que `sample_rate_hz` GUI->firmware esta pendiente.
- [ ] Se confirma que RevA funcional forma parte del prototipo y que produccion repetible queda fuera de esta prueba.
