hujjika1099-glitch/Repo/data/processed/sensor_C_coupled_linear_validation_20260322_132133.csv

pose | run_file | samples | duration_s | freq_hz | seq_jumps | mean_mv_x | mean_mv_y | mean_mv_z | coupled_mean_gx | coupled_mean_gy | coupled_mean_gz | coupled_mean_gnorm | coupled_mean_error_gnorm | coupled_max_error_gnorm | coupled_expected_axis_mean | coupled_cross_axis_abs_mean | coupled_dominant_axis | coupled_dominant_sign | coupled_axis_match | coupled_sign_match | coupled_exact_match | simple_mean_gx | simple_mean_gy | simple_mean_gz | simple_mean_gnorm | simple_mean_error_gnorm | simple_max_error_gnorm | simple_expected_axis_mean | simple_cross_axis_abs_mean
pos_x | sensor_C_pos_x_20260322_111504.csv | 796 | 7.949102 | 100.011296873534 | 0 | 2913.24497487437 | 1293.43844221106 | 1293.9648241206 | 0.119367249151129 | -0.322355452079075 | -0.111763233238761 | 0.361458985168435 | 0.638541014831565 | 0.638541014831565 | 0.119367249151129 | 0.217059342658918 | y | -1 | 0 | 0 | 0 | -3.68737471871238 | 1.04573359239828 | -1.80744205160545 | 4.23758632152564 | 3.23758632152564 | 3.23758632152564 | -3.68737471871238 | 1.42658782200187
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
