hujjika1099-glitch/Repo/data/processed/sensor_C_coupled_regularized_validation_20260322_135643.csv

pose | run_file | samples | duration_s | freq_hz | seq_jumps | mean_mv_x | mean_mv_y | mean_mv_z | mean_gx | mean_gy | mean_gz | mean_gnorm | mean_error_gnorm | max_error_gnorm | expected_axis_mean | cross_axis_abs_mean | dominant_axis | dominant_sign | axis_match | sign_match | exact_match
pos_x | sensor_C_pos_x_20260322_111504.csv | 796 | 7.949102 | 100.011296873534 | 0 | 2913.24497487437 | 1293.43844221106 | 1293.9648241206 | 0.108246016608875 | -0.311327300845368 | -0.124729902157961 | 0.35241940476609 | 0.64758059523391 | 0.64758059523391 | 0.108246016608875 | 0.218028601501664 | y | -1 | 0 | 0 | 0
pos_x | sensor_C_pos_x_20260322_111643.csv | 792 | 7.909106 | 100.011303426708 | 0 | 2770.12752525253 | 1299.78282828283 | 1297.93181818182 | -0.13668556405325 | -0.052184719288765 | -0.411994464864913 | 0.437202044170802 | 0.562797955829198 | 0.562797955829198 | -0.13668556405325 | 0.232089592076839 | z | -1 | 0 | 0 | 0
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
