hujjika1099-glitch/Repo/data/processed/SensorB_Prueba_live2_20260322_213556_processed.csv

seq | t_us | wall_s | raw_x | raw_y | raw_z | mv_x | mv_y | mv_z | gx_est | gy_est | gz_est | g_norm_est
0 | 340059 | 0.0863978 | 1871 | 1757 | 1487 | 1693 | 1576 | 1364 | -0.00508333333333364 | -0.007966666666667 | 0.00140000000000024 | 0.00955343161149776
1 | 349296 | 0.0886203 | 1885 | 1749 | 1487 | 1691 | 1576 | 1364 | -0.0117500000000003 | -0.007966666666667 | 0.00140000000000024 | 0.0142650018499049
2 | 359295 | 0.090649 | 1892 | 1748 | 1488 | 1698 | 1575 | 1355 | 0.011583333333333 | -0.0113000000000003 | -0.0285999999999998 | 0.0328606696692429
3 | 369296 | 0.0926641 | 1892 | 1744 | 1488 | 1699 | 1579 | 1364 | 0.0149166666666664 | 0.002033333333333 | 0.00140000000000024 | 0.0151195697322668
4 | 379295 | 0.0962481 | 1895 | 1758 | 1488 | 1696 | 1586 | 1364 | 0.00491666666666636 | 0.0253666666666663 | 0.00140000000000024 | 0.0258766572201448
5 | 389296 | 0.0997158 | 1891 | 1751 | 1488 | 1695 | 1579 | 1364 | 0.00158333333333303 | 0.002033333333333 | 0.00140000000000024 | 0.00293281245375275
6 | 399295 | 0.1006621 | 1888 | 1744 | 1488 | 1695 | 1576 | 1364 | 0.00158333333333303 | -0.007966666666667 | 0.00140000000000024 | 0.00824225225422198
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
