hujjika1099-glitch/Repo/data/processed/SensorB_Prueba_live3_20260322_214721_processed.csv

seq | t_us | wall_s | raw_x | raw_y | raw_z | mv_x | mv_y | mv_z | gx_est | gy_est | gz_est | g_norm_est
19 | 529293 | 0.0394901 | 1853 | 1750 | 1535 | 1693 | 1580 | 1402 | 0.00193333333333309 | 0.000999999999999848 | -0.00413333333333336 | 0.00467142614436119
20 | 539293 | 0.0490098 | 1889 | 1746 | 1535 | 1705 | 1580 | 1402 | 0.0419333333333331 | 0.000999999999999848 | -0.00413333333333336 | 0.0421484150222623
21 | 549293 | 0.0557224 | 1887 | 1758 | 1535 | 1689 | 1579 | 1402 | -0.0114000000000002 | -0.00233333333333348 | -0.00413333333333336 | 0.012348639151295
22 | 559293 | 0.0571368 | 1893 | 1754 | 1564 | 1690 | 1578 | 1421 | -0.00806666666666691 | -0.00566666666666682 | 0.0592 | 0.0600151832640893
23 | 569293 | 0.0579354 | 1893 | 1750 | 1535 | 1694 | 1580 | 1402 | 0.00526666666666642 | 0.000999999999999848 | -0.00413333333333336 | 0.00676921134418328
24 | 579293 | 0.0586417 | 1892 | 1751 | 1535 | 1697 | 1575 | 1421 | 0.0152666666666664 | -0.0156666666666668 | 0.0592 | 0.0631122456862022
25 | 589293 | 0.0593956 | 1890 | 1749 | 1534 | 1681 | 1578 | 1402 | -0.0380666666666669 | -0.00566666666666682 | -0.00413333333333336 | 0.0387074497566901
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
