hujjika1099-glitch/Repo/data/processed/sensor_B_live_Prueba1_live_20260322_211749_processed.csv

seq | t_us | wall_s | raw_x | raw_y | raw_z | mv_x | mv_y | mv_z | gx_est | gy_est | gz_est | g_norm_est
84 | 1179289 | 0.194906 | 1903 | 1731 | 1442 | 1705 | 1566 | 1326 | 0.00414999999999964 | 0.0140666666666668 | 0.00393333333333355 | 0.0151843578139552
85 | 1189289 | 0.2194079 | 1904 | 1730 | 1440 | 1704 | 1560 | 1326 | 0.000816666666666303 | -0.00593333333333324 | 0.00393333333333355 | 0.00716536809940704
86 | 1199289 | 0.2344786 | 1900 | 1733 | 1449 | 1705 | 1566 | 1325 | 0.00414999999999964 | 0.0140666666666668 | 0.000600000000000212 | 0.0146783381590394
87 | 1209289 | 0.243867 | 1905 | 1728 | 1442 | 1705 | 1563 | 1325 | 0.00414999999999964 | 0.00406666666666676 | 0.000600000000000212 | 0.00584125652388044
88 | 1219288 | 0.2736976 | 1902 | 1727 | 1445 | 1707 | 1562 | 1325 | 0.0108166666666663 | 0.000733333333333424 | 0.000600000000000212 | 0.0108580871038847
89 | 1229289 | 0.2810629 | 1909 | 1734 | 1445 | 1703 | 1562 | 1325 | -0.00251666666666703 | 0.000733333333333424 | 0.000600000000000212 | 0.00268912418621586
90 | 1239289 | 0.2829437 | 1918 | 1731 | 1442 | 1705 | 1570 | 1326 | 0.00414999999999964 | 0.0274000000000001 | 0.00393333333333355 | 0.0279902413549993
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
