hujjika1099-glitch/Repo/data/processed/sensor_C_coupled_linear_validation_20260322_132133_poses.csv

pose | runs_found | seq_jumps_total | freq_mean_hz | mean_gx | mean_gy | mean_gz | mean_gnorm | mean_error_gnorm | max_error_gnorm | mean_expected_axis | mean_cross_axis_abs | dominant_axis | dominant_sign | axis_match | sign_match | exact_match | simple_mean_gnorm | simple_mean_error_gnorm | simple_max_error_gnorm | simple_mean_expected_axis | simple_mean_cross_axis_abs
pos_x | 3 | 0 | 100.011305457345 | 0.0683063519018001 | -0.2593829601593 | -0.163096478073588 | 0.443699749899055 | 0.556300250100945 | 0.638541014831565 | 0.0683063519018001 | 0.232486900851991 | y | -1 | 0 | 0 | 0 | 4.07745017710737 | 3.07745017710737 | 3.23758632152564 | -3.51665455122595 | 1.4077725520929
neg_x | 3 | 0 | 100.01132235577 | -0.0268059206213811 | -0.0333841773899956 | -0.0661441659844731 | 0.127025605389478 | 0.872974394610522 | 0.925439430546085 | 0.0268059206213811 | 0.0709198086694776 | z | -1 | 0 | 0 | 0 | 4.09567567762971 | 3.09567567762971 | 3.25001908902402 | 3.71344012901418 | 1.17071103586477
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
