hujjika1099-glitch/Repo/reports/change_log.md

# Change Log del Proyecto

## Proposito
Registro tecnico y trazable de cambios relevantes del repositorio.

## Plantilla de Registro
| Fecha | Fase | Archivo o Componente Afectado | Tipo de Cambio | Motivo | Impacto | Riesgo |
|---|---|---|---|---|---|---|
| AAAA-MM-DD | Fase X | ruta/archivo | alta/modificacion/correccion | razon del cambio | resultado esperado | bajo/medio/alto |

## Registros
| Fecha | Fase | Archivo o Componente Afectado | Tipo de Cambio | Motivo | Impacto | Riesgo |
|---|---|---|---|---|---|---|
| 2026-03-20 | Fase 1 Bootstrap Local | Estructura de carpetas, `README.md`, `.gitignore`, `AGENTS.md`, `.codex/`, `.vscode/`, `hardware/`, `reports/`, `data/`, `prompts/` | alta/modificacion | Establecer base profesional local con trazabilidad y reglas operativas sin tocar remoto ni toolchain de firmware | Repo preparado para fases tecnicas siguientes con control documental y de datos | bajo |
| 2026-03-20 | Fase 1 Bootstrap Local | `.vscode/tasks.json` | diferido | Toolchain incompleto (`pio/platformio` no disponible en PATH) y se evita configurar tareas prematuras o ficticias | Se pospone definicion de tareas funcionales a fase posterior de toolchain | bajo |
| 2026-03-20 | Fase 3 Toolchain Local Firmware | Diagnostico de PlatformIO en terminal integrada, `.vscode/tasks.json`, `firmware/single_node_calibration/platformio.ini`, `firmware/single_node_calibration/src/main.cpp`, `reports/toolchain_status.md`, `README.md` | alta/modificacion | Habilitar flujo local real de firmware con ejecutable verificado sin tocar remoto ni instalar dependencias nuevas | VS Code queda con tareas operativas para build/upload/monitor/clean sobre scaffolding minimo de firmware | medio |
| 2026-03-20 | Fase 4 Firmware Baseline ADXL335 | `firmware/single_node_calibration/src/main.cpp`, `reports/single_node_firmware_baseline.md` | alta/modificacion | Implementar adquisicion minima real (ADC raw + mV + seq + t_us) para validacion individual y compilar en entorno local | Baseline funcional listo para carga posterior en ESP32 de referencia; salida serial estable para captura y analisis | medio |
| 2026-03-20 | Fase 4 Firmware Baseline ADXL335 | Entorno local PlatformIO (`~/.platformio/penv`) | correccion | Resolver error de compilacion por dependencia faltante (`intelhex`) detectada en `tool-esptoolpy` | Build recuperado y validado con resultado `SUCCESS` | bajo |
| 2026-03-20 | Fase 5 Upload y Monitor Single Node | `firmware/single_node_calibration/platformio.ini`, `reports/single_node_upload_and_monitor.md` | alta/modificacion | Ejecutar validacion operativa de upload/monitor en COM5 sin tocar remoto | Puerto y monitor verificados; upload bloqueado por boot mode `0x13`, requiere intervencion manual BOOT/EN para aplicar baseline | medio |
| 2026-03-20 | Fase 5.1 Guided Bootloader Upload | `firmware/single_node_calibration/platformio.ini`, `reports/single_node_bootloader_guided_upload.md` | alta/modificacion | Reintentar upload con secuencia manual BOOT/EN (maximo 2 intentos) y validar stream final | Intento 2 exitoso; baseline CSV confirmado en monitor serie; estado `ready_for_matlab` | medio |
| 2026-03-20 | Fase 6 MATLAB Capture Single Sensor | `matlab/calibration/capture_single_sensor_baseline.m`, `.vscode/tasks.json`, `data/raw/sensor_A/sensor_A_z_plus_static_20260320_132709.csv`, `data/raw/sensor_A/sensor_A_z_plus_static_20260320_132709_session.txt`, `reports/single_node_matlab_capture_baseline.md` | alta/modificacion | Implementar y validar primera captura MATLAB funcional individual para `sensor_A` en COM5 | Captura real guardada sin sobrescritura, formato validado, frecuencia estimada ~100 Hz, estado `matlab_capture_ok` | medio |
| 2026-03-20 | Fase 7 Analisis Basico y Repetibilidad Misma Pose | `matlab/analysis/analyze_single_capture_baseline.m`, `matlab/analysis/analyze_repeatability_same_pose.m`, `.vscode/tasks.json`, `reports/analysis_outputs/*`, `reports/sensor_A_single_capture_analysis.md`, `reports/repeatability_next_step_plan.md` | alta/modificacion | Crear flujo reproducible de analisis individual y preparar comparacion de repetibilidad para `sensor_A` en `z_plus_static` sin iniciar multipose | Analisis individual ejecutado con metricas/figuras; preparacion de repetibilidad lista con `runs_found=1` y plan operativo para 2-3 corridas adicionales | medio |
| 2026-03-20 | Fase 8 Repetibilidad Misma Pose | `data/raw/sensor_A/sensor_A_z_plus_static_20260320_135921.csv`, `data/raw/sensor_A/sensor_A_z_plus_static_20260320_135921_session.txt`, `data/raw/sensor_A/sensor_A_z_plus_static_20260320_140052.csv`, `data/raw/sensor_A/sensor_A_z_plus_static_20260320_140052_session.txt`, `reports/analysis_outputs/sensor_A_z_plus_static_repeatability_20260320_140207.*`, `reports/sensor_A_repeatability_assessment.md` | alta/modificacion | Ejecutar corridas adicionales reales en misma pose y evaluar repetibilidad antes de multipose | Se alcanzaron 3 corridas totales; stream estable pero dispersion alta en medias de eje Z, decision `repeatability_issue` | medio |
| 2026-03-20 | Fase 8.1 Repetibilidad Reforzada | `data/raw/sensor_A/sensor_A_z_plus_static_20260320_141206.csv`, `data/raw/sensor_A/sensor_A_z_plus_static_20260320_141206_session.txt`, `data/raw/sensor_A/sensor_A_z_plus_static_20260320_165156.csv`, `data/raw/sensor_A/sensor_A_z_plus_static_20260320_165156_session.txt`, `data/raw/sensor_A/sensor_A_z_plus_static_20260320_165401.csv`, `data/raw/sensor_A/sensor_A_z_plus_static_20260320_165401_session.txt`, `reports/analysis_outputs/sensor_A_z_plus_static_repeatability_20260320_165502.*`, `reports/sensor_A_repeatability_retest.md` | alta/modificacion | Repetir z_plus_static con control fisico reforzado y reevaluar si la dispersion disminuye antes de habilitar multipose | Pipeline digital estable confirmado de nuevo; la dispersion en eje Z aumenta respecto a la evaluacion previa y se mantiene `repeatability_issue_persists` | medio |
| 2026-03-21 | Fase Screening 3 Sensores Misma Pose | `matlab/calibration/capture_single_sensor_baseline.m`, `matlab/analysis/analyze_repeatability_same_pose.m`, `matlab/analysis/analyze_sensor_screening_same_pose.m`, `.vscode/tasks.json`, `data/raw/sensor_A/*171159..171823*`, `data/raw/sensor_B/*180404..181012*`, `data/raw/sensor_C/*092728..093618*`, `reports/analysis_outputs/sensor_[A|B|C]_z_plus_static_repeatability_20260321_*.{csv,txt}`, `reports/analysis_outputs/sensor_screening_z_plus_static_20260321_095249_*`, `reports/sensor_screening_same_pose_comparison.md` | alta/modificacion | Ejecutar screening comparativo controlado (5 corridas por sensor) en misma ESP32/COM5/pose con estabilizacion minima de 20 s para discriminar comportamiento por sensor vs condicion de prueba | `sensor_C` queda como `candidate_preferred_sensor`; `sensor_A` y `sensor_B` quedan `sensor_suspect`; se mantiene etiqueta de sistema `fixture_issue` por dispersion alta en dos sensores durante intercambio | medio |
| 2026-03-21 | Fase 9 Multipose Estatico sensor_C | `data/raw/sensor_C/sensor_C_{pos_x,neg_x,pos_y,neg_y,pos_z,neg_z}_*.csv`, `data/raw/sensor_C/sensor_C_{pos_x,neg_x,pos_y,neg_y,pos_z,neg_z}_*_session.txt`, `matlab/analysis/analyze_repeatability_same_pose.m`, `matlab/analysis/analyze_sensorC_multipose_static.m`, `reports/analysis_outputs/sensor_C_{pos_x,neg_x,pos_y,neg_y,pos_z,neg_z}_repeatability_20260321_*.{csv,txt}`, `reports/analysis_outputs/sensor_C_multipose_static_20260321_120320_*`, `reports/sensor_C_multipose_static_validation.md`, `hardware/sensor_registry.csv` | alta/modificacion | Validar coherencia estatica de `sensor_C` en 6 poses con misma ESP32/COM5/firmware baseline, 3 corridas por pose y estabilizacion minima real de 20 s | Flujo digital estable en todas las poses; pares X/Y coherentes, pero par Z inconsistente (dominancia en eje X), decision `multipose_inconsistent` y retesteo de pose Z requerido antes de calibracion final | medio |
| 2026-03-21 | Fase 9.1 Retesteo Focalizado Par Z sensor_C | `data/raw/sensor_C/sensor_C_{pos_z,neg_z}_20260321_12*.csv`, `data/raw/sensor_C/sensor_C_{pos_z,neg_z}_20260321_12*_session.txt`, `reports/analysis_outputs/sensor_C_{pos_z,neg_z}_repeatability_20260321_1254*.{csv,txt}`, `matlab/analysis/analyze_sensorC_zpair_retest.m`, `reports/analysis_outputs/sensor_C_zpair_retest_20260321_125701_*`, `reports/sensor_C_zpair_retest.md`, `hardware/sensor_registry.csv`, `reports/change_log.md` | alta/modificacion | Repetir solo `pos_z` y `neg_z` con control mecanico reforzado (5 corridas por pose, misma ESP32/COM5, estabilizacion minima real de 20 s) y comparar explicitamente contra Fase 9 | Mejora parcial en dominancia (ratio Z sube de 0.269618 a 0.958792), pero eje dominante sigue en X; decision `z_pair_still_inconsistent`, no apto aun para `ready_for_final_calibration` | medio |
| 2026-03-21 | Fase 9.2 Validacion Definitiva Par Z sensor_C | `data/raw/sensor_C/sensor_C_{pos_z,neg_z}_20260321_13*.csv`, `data/raw/sensor_C/sensor_C_{pos_z,neg_z}_20260321_13*_session.txt`, `reports/analysis_outputs/sensor_C_{pos_z,neg_z}_repeatability_20260321_133*.{csv,txt}`, `matlab/analysis/analyze_sensorC_zpair_retest.m`, `reports/analysis_outputs/sensor_C_zpair_retest_20260321_133945_*`, `reports/sensor_C_zpair_final_assessment.md`, `hardware/sensor_registry.csv` | alta/modificacion | Ejecutar retesteo definitivo del par Z con fixture angular explicito (5 corridas por pose, misma ESP32/COM5, estabilizacion minima real de 20 s) y evaluar criterios obligatorios contra Fase 9 y 9.1 | Se cumplen 4/4 criterios (`dominant_axis=z`, `dominance_ratio=1.887340`, `abs(delta_mv_z)=405.424346`, `seq_jumps_total=0`), decision `z_pair_fixed` y `ready_for_final_calibration=yes` | medio |
| 2026-03-21 | Fase 10 Calibracion Final Estatica sensor_C | `matlab/calibration/calibrate_sensorC_static_6pose.m`, `matlab/analysis/validate_sensorC_static_calibration.m`, `reports/sensor_C_final_static_calibration.md`, `data/processed/sensor_C_static_calibration_20260321_140044.{mat,csv}`, `data/processed/sensor_C_static_validation_20260321_140524*.csv`, `reports/analysis_outputs/sensor_C_static_calibration_20260321_140044_*`, `reports/analysis_outputs/sensor_C_static_validation_20260321_140524.txt`, `hardware/sensor_registry.csv`, `.vscode/tasks.json` | alta/modificacion | Construir calibracion estatica final por eje (raw y mV) con dataset multipose validado y par Z corregido, y ejecutar validacion cruzada reproducible | Coeficientes finales generados y validados sin `seq_jumps`; decision automatica de validacion `calibrated_but_review_needed` por error de norma elevado en poses puntuales (sin promover aun a etapa final) | medio |
| 2026-03-21 | Fase 10.1 Calibracion Refinada Affine 3x3 sensor_C | `matlab/calibration/calibrate_sensorC_static_affine_3x3.m`, `matlab/analysis/validate_sensorC_static_affine_3x3.m`, `reports/sensor_C_refined_static_calibration.md`, `data/processed/sensor_C_static_affine_3x3_20260321_142515.{mat,csv}`, `data/processed/sensor_C_static_affine_3x3_validation_20260321_142847*.csv`, `reports/analysis_outputs/sensor_C_static_affine_3x3_20260321_142515_*`, `reports/analysis_outputs/sensor_C_static_affine_3x3_validation_20260321_142847_*`, `hardware/sensor_registry.csv`, `.vscode/tasks.json` | alta/modificacion | Reutilizar dataset de Fase 10 para ajustar modelo `g = M*(v-b)` y comparar explicitamente contra calibracion simple por eje | El modelo affine no mejora globalmente (`mean_error_|g|` sube de 0.0971 a 0.1474); mejora parcial en `pos_z` pero empeora `neg_y`; decision final `calibrated_but_review_needed` y sin promocion a siguiente etapa | medio |
| 2026-03-21 | Fase 10.2 Recaptura Focalizada neg_y/pos_z + Recalibracion Simple | `data/raw/sensor_C/sensor_C_neg_y_20260321_14*.csv`, `data/raw/sensor_C/sensor_C_neg_y_20260321_14*_session.txt`, `data/raw/sensor_C/sensor_C_pos_z_20260321_15*.csv`, `data/raw/sensor_C/sensor_C_pos_z_20260321_15*_session.txt`, `matlab/calibration/recalibrate_sensorC_static_negY_posZ.m`, `matlab/analysis/compare_sensorC_static_validation_vs_phase10.m`, `data/processed/sensor_C_static_calibration_20260321_151516.{mat,csv}`, `data/processed/sensor_C_static_validation_20260321_151629*.csv`, `reports/analysis_outputs/sensor_C_static_calibration_20260321_151516_*`, `reports/analysis_outputs/sensor_C_static_validation_retest_negY_posZ_20260321_151740_*`, `reports/sensor_C_static_calibration_retest_negY_posZ.md`, `hardware/sensor_registry.csv` | alta/modificacion | Recapturar solo poses problematicas `neg_y` y `pos_z` (5 corridas c/u, 20 s estabilizacion) y recalcular modelo simple comparandolo contra Fase 10 | Integridad digital estable (`seq_jumps=0`) pero recalibracion degradada en `neg_y/pos_z` con aumento severo de error global (`0.0971 -> 1.2153`); decision final `calibrated_but_review_needed`, sin promocion a siguiente etapa y se conserva modelo simple de Fase 10 como baseline | medio |
| 2026-03-22 | Fase 10.3 Diagnostico Convencion Ejes/Signos sensor_C | `matlab/analysis/diagnose_sensorC_axis_convention.m`, `.vscode/tasks.json`, `reports/analysis_outputs/sensor_C_axis_convention_dataset_phase103.csv`, `data/raw/sensor_C/sensor_C_{pos_x,neg_x,pos_y,neg_y,pos_z,neg_z}_20260322_*.csv`, `data/raw/sensor_C/sensor_C_{pos_x,neg_x,pos_y,neg_y,pos_z,neg_z}_20260322_*_session.txt`, `reports/analysis_outputs/sensor_C_axis_convention_diagnosis_20260322_105051_*`, `reports/sensor_C_axis_convention_diagnosis.md` | alta/modificacion | Diagnosticar mapeo real pose-canal y signos antes de recalibrar, usando protocolo corto (2 corridas/pose, 8 s, estabilizacion 15 s), misma ESP32 y COM5, con exclusion explicita de corridas `neg_x` movidas | Se detectan conflictos de convencion/mapeo (`sign_inverted` en `neg_x`, `axis_permuted` en `pos_y/neg_y/pos_z/neg_z`) y ambiguedad residual en pares `x/z`; decision `mapping_inconclusive` y recomendacion de repetir diagnostico con fixture mas restrictivo | medio |
| 2026-03-22 | Fase 10.4 Diagnostico Reforzado Convencion Ejes/Signos sensor_C | `matlab/analysis/diagnose_sensorC_axis_convention_phase104.m`, `.vscode/tasks.json`, `reports/analysis_outputs/sensor_C_axis_convention_dataset_phase104.csv`, `data/raw/sensor_C/sensor_C_{pos_x,neg_x,pos_y,neg_y,pos_z,neg_z}_20260322_11*.csv`, `data/raw/sensor_C/sensor_C_{pos_x,neg_x,pos_y,neg_y,pos_z,neg_z}_20260322_11*_session.txt`, `reports/analysis_outputs/sensor_C_axis_convention_phase104_20260322_115411_*`, `reports/sensor_C_axis_convention_diagnosis_phase104.md`, `hardware/sensor_registry.csv` | alta/modificacion | Repetir diagnostico de mapeo/signos con protocolo mas estricto (3 corridas/pose, 8 s, estabilizacion 20 s, fixture angular reforzado, mismo sensor_C/ESP32/COM5) para intentar cerrar incertidumbre de Fase 10.3 | Integridad digital estable (`seq_jumps=0`) pero pares `x/y/z` quedan ambiguos por baja separacion relativa; inferencia global no cierra mapeo univoco, decision final `mapping_inconclusive` y se difiere cualquier ajuste de calibracion | medio |
| 2026-03-22 | Fase 10.5 Busqueda Exhaustiva de Mapeo/Signo sensor_C | `matlab/analysis/search_sensorC_axis_mapping_hypotheses.m`, `reports/analysis_outputs/sensor_C_axis_mapping_search_dataset_20260322_121904.csv`, `reports/analysis_outputs/sensor_C_axis_mapping_search_20260322_122519_*`, `reports/sensor_C_axis_mapping_search.md`, `.vscode/tasks.json`, `hardware/sensor_registry.csv` | alta/modificacion | Cambiar enfoque a identificacion automatica de hipotesis (48 combinaciones de permutacion+signo) usando solo dataset ya capturado, sin nuevas adquisiciones | Se obtiene ranking reproducible pero con empate de hipotesis lideres y error de norma alto; decision final `mapping_ambiguous`, sin aplicar remapeo definitivo ni recalibrar aun | medio |
| 2026-03-22 | Fase 10.6 Desambiguacion Fisica de Mapeo/Signo sensor_C | `matlab/analysis/disambiguate_sensorC_axis_mapping_physical.m`, `reports/analysis_outputs/sensor_C_axis_mapping_disambiguation_dataset_20260322_125115.csv`, `reports/analysis_outputs/sensor_C_axis_mapping_disambiguation_20260322_130308_*`, `reports/sensor_C_axis_mapping_disambiguation.md`, `.vscode/tasks.json`, `hardware/sensor_registry.csv` | alta/modificacion | Aplicar scoring fisico reforzado, colapso por familias de permutacion y referencia nula por aleatorizacion para evaluar si existe soporte real de mapeo simple con datos existentes | Se rompe parcialmente el empate, pero la mejor hipotesis no supera referencia nula p95 y solo 1/3 pares cumple eje esperado; decision final `mapping_not_supported`, sin tocar scripts de calibracion aun | medio |
| 2026-03-22 | Fase 10.7 Modelo Lineal Acoplado sensor_C | `matlab/calibration/fit_sensorC_coupled_linear_model.m`, `matlab/analysis/validate_sensorC_coupled_linear_model.m`, `reports/analysis_outputs/sensor_C_coupled_model_dataset_20260322_131829.csv`, `reports/analysis_outputs/sensor_C_coupled_linear_model_20260322_131829_*`, `data/processed/sensor_C_coupled_linear_model_20260322_131829.{csv,mat}`, `data/processed/sensor_C_coupled_linear_validation_20260322_132133*.csv`, `reports/analysis_outputs/sensor_C_coupled_linear_validation_20260322_132133_*`, `reports/sensor_C_coupled_linear_model_assessment.md`, `.vscode/tasks.json`, `hardware/sensor_registry.csv` | alta/modificacion | Probar interpretacion acoplada `g = A*v + c` con el mismo dataset fijo de 18 corridas, comparando contra modelo simple y contra resultado simple de Fase 10.6 | Mejora global fuerte en error de norma y pares respecto al simple, pero persiste debilidad en `x_pair`; decision final `coupled_model_weak`, sin promover aun a baseline productivo | medio |
| 2026-03-22 | Fase 10.8 Modelo Acoplado Regularizado sensor_C | `matlab/calibration/fit_sensorC_coupled_linear_regularized.m`, `matlab/analysis/validate_sensorC_coupled_linear_regularized.m`, `matlab/analysis/coupled_*.m`, `reports/analysis_outputs/sensor_C_coupled_robust_dataset_20260322_135412.csv`, `reports/analysis_outputs/sensor_C_coupled_regularized_candidates_20260322_135412.*`, `reports/analysis_outputs/sensor_C_coupled_regularized_selection_20260322_135643.csv`, `data/processed/sensor_C_coupled_regularized_model_20260322_135643.{csv,mat}`, `data/processed/sensor_C_coupled_regularized_validation_20260322_135643*.csv`, `reports/analysis_outputs/sensor_C_coupled_regularized_validation_20260322_135643_*`, `reports/sensor_C_coupled_regularized_model_assessment.md`, `.vscode/tasks.json`, `hardware/sensor_registry.csv` | alta/modificacion | Evaluar robustez por regularizacion ridge y generalizacion interna (CV leave-one-run-per-pose-out) sin nuevas capturas y con dataset fijo de 18 corridas | El candidato regularizado seleccionado (`lambda=1`) no supera al modelo acoplado actual ni al baseline simple en error global; decision final `coupled_model_not_supported` y se mantiene estado `suspect` | medio |
| 2026-03-22 | Fase 10.8A Dossier para Consulta Experta | `reports/expert_consultation_sensorC_bottleneck_20260322.txt`, `reports/change_log.md` | alta/modificacion | Consolidar en un solo documento el estado tecnico, fallos historicos, evidencia numerica y preguntas concretas para revision externa experta | Facilita analisis independiente del cuello de botella y acelera decision de cambio de estrategia | bajo |
| 2026-03-30 | Fase 14B Bring-up Dual Node ESP-NOW | `firmware/dual_node_espnow/platformio.ini`, `firmware/dual_node_espnow/include/*.h`, `firmware/dual_node_espnow/src/*.cpp`, `reports/phase14b_dual_node_espnow_minimum_bringup.md`, `reports/change_log.md` | alta/modificacion | Escalar de captura serial directa a una topologia minima inalambrica con una ESP32 sensor y una ESP32 relay USB, manteniendo intacto el contrato serial que consume MATLAB | Queda lista la primera arquitectura `1 acelerometro -> ESP-NOW -> 1 relay serial -> MATLAB` sin reescribir parser ni launcher live | medio |
| 2026-03-31 | Fase 14B.1 MATLAB Autodeteccion de Puerto | `matlab/common/resolve_adxl_serial_port.m`, `matlab/live/run_sensorB_live_session.m`, `matlab/calibration/capture_single_sensor_baseline.m`, `matlab/calibration/capture_sensorC_selftest_pair.m`, `matlab/analysis/run_adxl335_fast_bringup.m`, `reports/matlab_serial_port_autodetect.md` | correccion | El flujo live/captura seguia rompiendose por dependencia a `COM5` fijo y se requiere priorizar un unico concentrador USB aunque Windows reasigne el puerto | MATLAB ahora puede resolver automaticamente el relay/stream serial, registrar como se eligio el puerto y fallar con diagnostico claro cuando haya ambiguedad real | bajo |
| 2026-03-31 | Fase 14B.2 Handoff Arduino IDE Dual Node | `firmware/dual_node_espnow/arduino_ide/*`, `reports/phase14b_dual_node_arduino_ide_handoff.md` | alta/modificacion | Preparar el flujo dual node para carga manual desde Arduino IDE sin depender de la estructura de PlatformIO | Quedan dos sketches autocontenidos, uno para transmisor ADXL335 y otro para receptor USB, con el mismo contrato serial esperado por MATLAB | bajo |
| 2026-03-31 | Fase 14C Multiplex Dual Sensor ESP-NOW | `firmware/dual_node_espnow/include/*.h`, `firmware/dual_node_espnow/src/*.cpp`, `firmware/dual_node_espnow/arduino_ide/*`, `matlab/live/parse_adxl335_stream_line.m`, `matlab/live/run_sensorB_live_session.m`, `matlab/common/resolve_adxl_serial_port.m`, `live_session_hub/sensorB_live_prompt_session.m`, `reports/phase14c_dual_sensor_espnow_multiplex.md`, `firmware/dual_node_espnow/phase14b_transport_contract.json` | alta/modificacion | Escalar de un solo transmisor a dos sensores simultaneos con identidad explicita por sensor y evaluacion minima del segundo sensor en MATLAB | El receptor ahora multiplexa ambos sensores en un solo stream CSV con `sensor_id`, MATLAB los separa y reporta coherencia basica del segundo sensor antes de analisis posterior | medio |
| 2026-03-31 | Fase 14C.1 Export TXT por Rol | `handoff/phase14c_dual_sensor_exports/*`, `reports/change_log.md` | correccion | Facilitar copia/pegado operativo separando material por MATLAB, receptor, transmisor 1 y transmisor 2 | Quedan cuatro `.txt` listos para handoff directo sin tener que reconstruir manualmente que archivo corresponde a cada equipo | bajo |
| 2026-03-31 | Fase 14C.2 Ajuste Live Dual Sensor MATLAB | `matlab/live/run_sensorB_live_session.m`, `live_session_hub/sensorB_live_prompt_session.m`, `live_session_hub/matlab_live_session_code.txt`, `reports/change_log.md` | correccion | Resolver fallo por estructuras incompatibles, evitar tasa aparente inflada por stream intercalado y simplificar la campana live para dos sensores con grafica solo en `g` | El launcher ahora solo pide duracion y nombre base, guarda siempre evidencia, compara `|g|` de ambos sensores en vivo y emite progreso por sensor con tasas coherentes | bajo |
| 2026-03-31 | Fase 14C.3 Robustez Parser Stream MATLAB | `matlab/live/parse_adxl335_stream_line.m`, `reports/change_log.md` | correccion | El stream serial podia entregar texto parcial o no escalar y la comparacion de cabecera con `||` provocaba error fatal en MATLAB | El parser ahora normaliza entradas vacias/parciales y detecta cabeceras de forma segura sin abortar la sesion live | bajo |
| 2026-03-31 | Fase 14C.4 Evaluacion de Readiness de Probes Dual Sensor | `reports/dual_sensor_probe_readiness_20260331.md`, `reports/change_log.md` | alta/modificacion | Determinar si las corridas `probe1`-`probe4` ya permiten analisis rigurosos o si la campana dual requiere endurecimiento metodologico | La evidencia queda consolidada con decision explicita de no avanzar aun a analisis rigurosos y con un protocolo minimo mas estricto para la siguiente fase | bajo |
| 2026-03-31 | Fase 14C.5 Filtro de Integridad Dual en MATLAB Live | `matlab/live/run_sensorB_live_session.m`, `live_session_hub/sensorB_live_prompt_session.m`, `live_session_hub/matlab_live_session_code.txt`, `reports/change_log.md` | alta/modificacion | Endurecer la campana dual para rechazar automaticamente sistemas con ejes muertos, resets o integridad insuficiente antes de iniciar una corrida principal | La sesion live ahora ejecuta un precheck dual de 10 s, genera reporte de precheck y deja decision formal de integridad para toda captura guardada | bajo |
| 2026-04-12 | Fase 15 GUI Live Python | `gui/adxl_live_core.py`, `gui/adxl_live_gui.py`, `requirements-gui.txt`, `scripts/install_gui_requirements.ps1`, `scripts/run_sensorB_live_session.ps1`, `live_session_hub/sensorB_live_gui_session.ps1`, `README.md`, `AGENTS.md`, `.vscode/tasks.json`, `reports/gui_live_runtime_migration_20260412.md`, `reports/change_log.md` | alta/modificacion | MATLAB deja de ser viable para la ruta live y se requiere reemplazar la sesion interactiva por una GUI desktop que conserve el contrato serial, el precheck dual y la evidencia operativa | El repo queda reorientado a una GUI Python/Tkinter con graficas en tiempo real, autodeteccion de puerto, guardado `raw/processed/session.json` y launcher oficial fuera de MATLAB | medio |
| 2026-04-12 | Fase 15.1 Pulido UX GUI Live | `gui/adxl_live_gui.py`, `reports/change_log.md` | correccion | La primera GUI funcional seguia exponiendo demasiados campos tecnicos y no daba suficiente protagonismo visual a las graficas para el usuario final | La interfaz queda simplificada a un flujo de uso directo, con opciones avanzadas ocultas, metricas mas legibles, graficas mas grandes/centradas y una vista ampliada separada para monitoreo live | bajo |
| 2026-04-12 | Fase 15.2 Limpieza de lenguaje y estados GUI | `gui/adxl_live_gui.py`, `reports/change_log.md` | correccion | Aun quedaban nombres internos y estados demasiado tecnicos visibles para el operador final, especialmente en leyendas, conexion y salida guardada | La GUI pasa a hablar en terminos de sensor principal/secundario, reduce ruido operativo visible y deja la lectura de sesion mas natural sin perder capacidad de diagnostico | bajo |
| 2026-04-12 | Fase 15.3 Ajuste visual anti-recorte en GUI | `gui/adxl_live_gui.py`, `reports/change_log.md` | correccion | La distribucion anterior seguia permitiendo textos cortados en botones, tarjetas y mensajes visibles, lo que degradaba la apariencia profesional para el usuario final | Se ensancha el lateral, se apilan mejor los estados, se acortan controles visibles y las tarjetas adaptan su texto al ancho real para evitar recortes en la interfaz | bajo |
| 2026-04-12 | Fase 15.4 Robustez precheck y layout maximizado GUI | `gui/adxl_live_core.py`, `gui/adxl_live_gui.py`, `reports/change_log.md` | correccion | La sesion live podia abortar falsamente en el precheck por ausencia de header aun con datos validos y la ventana seguia dejando contenido fuera de vista aun en uso maximizado | El precheck ya no cae por falso negativo de header cuando el stream trae muestras reales, la app abre maximizada, compacta mejor el panel lateral y muestra mensajes de error cortos mientras reserva el detalle tecnico para logs y reportes | bajo |
| 2026-04-13 | Fase 15.5 Empaquetado como ejecutable standalone | `adxl_captura.spec`, `build_exe.ps1`, `gui/adxl_live_gui.py` (fix `_resolve_repo_root`), `.gitignore`, `reports/change_log.md` | alta/modificacion | La GUI solo era ejecutable desde el repo con Python instalado; se necesita distribuir a usuarios sin entorno de desarrollo | Se agrega spec de PyInstaller y script de build que genera `dist/ADXL335_Captura.exe` (10 MB standalone) y `dist/ADXL335_Captura_dist.zip`. Fix critico: `_resolve_repo_root()` detecta modo frozen via `sys.frozen` para guardar datos junto al `.exe` en lugar de en la carpeta temporal de extraccion. Los directorios `dist/` y `build_work/` quedan en `.gitignore` | medio |
| 2026-04-13 | Fase 15.6 Manual de usuario PDF | `build_manual_pdf.py`, `ADXL335_Captura_Manual.pdf`, `README.md`, `AGENTS.md`, `reports/change_log.md` | alta/modificacion | No existia documentacion de usuario que explicara la interfaz ni el significado de cada campo en los archivos exportados | Se genera `ADXL335_Captura_Manual.pdf` (65 paginas) via script Python con `fpdf2`. Cubre: instalacion, descripcion de cada control de la GUI, flujo de sesion, patron de nombres de archivo, referencia completa de todos los campos de `_raw.csv`, `_processed.csv`, `_session.json`, `_precheck.txt` y `_summary.txt`, tabla de todos los codigos de estado y razon, y FAQ. `README.md` y `AGENTS.md` actualizados para reflejar el estado completo del repositorio incluyendo el sistema de build y la distribucion exe | bajo |
| 2026-05-08 | Fase 15.7 Auditoria de sincronizacion Git | `reports/repository_sync_status_20260508.md`, `reports/change_log.md`, `ADXL335_Captura_Manual.pdf`, `README.md` | correccion/documentacion | Revisar estado local contra la nube configurada y cerrar el arbol local sin perder evidencia primaria | Se documenta que el remoto inicial apuntaba a una linea Control OKUA v2 divergente (`ahead/behind`) y que el push normal fue rechazado por `non-fast-forward`. Luego se configura el remoto correcto `hujjika1099-glitch/Repo.git`, compatible con fast-forward desde `2b348b9`; tras autorizar la llave SSH local se verifica acceso con `git ls-remote origin`. Se normaliza el manual al nombre canonico usado por README/build y se preservan datos crudos/reportes sin borrado | bajo |
| 2026-05-08 | `feature/kx134-dual-capture` / TICKET 001 | `docs/kx134_migration/README.md`, `docs/kx134_migration/WORKING_METHOD.md`, `docs/kx134_migration/REQUIREMENTS_BASELINE.md`, `docs/kx134_migration/TICKET_BACKLOG.md`, `reports/change_log.md` | alta/documentacion | Iniciar migracion SEN-17589/KX134 desde una rama limpia sin tocar firmware, GUI, data ni empaquetado | Se crea baseline documental de migracion KX134: proposito, diferencias ADXL335 vs KX134, regla sin voltajes, identidad fisica por sensor, calibracion individual, sincronizacion dual, topologia asumida, metodologia de trabajo y backlog de tickets futuros. No se modifico firmware funcional, GUI funcional ni empaquetado | bajo |
| 2026-05-08 | `feature/kx134-dual-capture` / TICKET 002 | `docs/kx134_migration/audits/TICKET_002_REPO_AUDIT.md`, `docs/kx134_migration/tickets/TICKET_002_AUDITORIA_TECNICA.md`, `docs/kx134_migration/TICKET_BACKLOG.md`, `reports/change_log.md` | alta/documentacion | Auditoria tecnica del repositorio para migracion KX134/SEN-17589 desde commit base `1d31f2abe1cbbfee623ff73a3d889fc83fae98fc` | Se documentan dependencias ADXL335, riesgos de firmware/receptor/GUI/exportacion/calibracion/empaquetado, decisiones pendientes y orden recomendado de tickets. No se modifico firmware, GUI ni empaquetado. Commit de auditoria: este mismo commit documental (`git log -1`) | bajo |
| 2026-05-08 | `feature/kx134-dual-capture` / TICKET 003 | `config/kx134_transport_contract_v3.json`, `docs/kx134_migration/DATA_CONTRACT_V3.md`, `docs/kx134_migration/tickets/TICKET_003_CONTRATO_DATOS_KX134_V3.md`, `docs/kx134_migration/TICKET_BACKLOG.md`, `reports/change_log.md` | alta/documentacion | Definicion documental del contrato de datos KX134 v3 | Se crea contrato JSON valido para dos sensores SEN-17589/KX134 con campos crudos, conversion basica a g, identidad, sincronizacion, calibracion individual, metadata de sesion, reglas de validacion y campos ADXL335 prohibidos. No se modifico firmware, GUI ni empaquetado. La arquitectura fisica ESP32 sigue pendiente de confirmacion | bajo |
| 2026-05-08 | `feature/kx134-dual-capture` / TICKET 004 | `docs/kx134_migration/ARCHITECTURE_V1.md`, `config/kx134_node_map_template.json`, `config/kx134_transport_contract_v3.json`, `docs/kx134_migration/DATA_CONTRACT_V3.md`, `docs/kx134_migration/REQUIREMENTS_BASELINE.md`, `docs/kx134_migration/TICKET_BACKLOG.md`, `docs/kx134_migration/tickets/TICKET_004_CERRAR_ARQUITECTURA_FISICA.md`, `reports/change_log.md` | alta/documentacion | Cierre documental de arquitectura fisica KX134 con tres ESP32 | Se documenta arquitectura con dos ESP32 sensoras, una ESP32 receptora, dos sensores SEN-17589/KX134, comunicacion ESP-NOW hacia receptor y salida Serial USB hacia aplicacion. Se crea plantilla de mapeo fisico de nodos/sensores. No se modifico firmware, GUI ni empaquetado. El rango g inicial sigue pendiente | bajo |
| 2026-05-09 | `feature/kx134-dual-capture` / TICKET 005 | `config/kx134_transport_contract_v3.json`, `config/kx134_node_map_template.json`, `docs/kx134_migration/DATA_CONTRACT_V3.md`, `docs/kx134_migration/ARCHITECTURE_V1.md`, `docs/kx134_migration/REQUIREMENTS_BASELINE.md`, `docs/kx134_migration/TICKET_BACKLOG.md`, `docs/kx134_migration/tickets/TICKET_005_AJUSTAR_ODR_KX134.md`, `docs/kx134_migration/tickets/TICKET_003_CONTRATO_DATOS_KX134_V3.md`, `docs/kx134_migration/audits/TICKET_002_REPO_AUDIT.md`, `reports/change_log.md` | correccion/documentacion | Ajuste documental de frecuencias ODR KX134 | Se retiran 500 Hz y 1000 Hz como opciones configurables actuales. Las frecuencias vigentes quedan en 100 Hz, 200 Hz, 400 Hz y 800 Hz, con default 100 Hz. Se documenta que 800 Hz queda pendiente de validacion en firmware/libreria por posible requerimiento de High-Performance. No se modifico firmware, GUI ni empaquetado | bajo |
| 2026-05-09 | `feature/kx134-dual-capture` / TICKET 006 | `firmware/kx134_single_node_i2c/platformio.ini`, `firmware/kx134_single_node_i2c/src/main.cpp`, `firmware/kx134_single_node_i2c/README.md`, `docs/kx134_migration/FIRMWARE_SINGLE_NODE_KX134_I2C.md`, `docs/kx134_migration/tickets/TICKET_006_FIRMWARE_SINGLE_NODE_KX134_I2C.md`, `docs/kx134_migration/TICKET_BACKLOG.md`, `reports/change_log.md` | alta/firmware_prototipo | Creacion de firmware minimo KX134 single-node por I2C/Qwiic | Se agrega proyecto PlatformIO aislado para una ESP32 sensora con lectura cruda digital `x_raw/y_raw/z_raw`, conversion basica `x_g/y_g/z_g`, sample rates 100/200/400/800 Hz, default 100 Hz, rango default de prueba 8 g y salida Serial CSV de prototipo compatible con contrato KX134 v3. ESP-NOW no implementado todavia; calibracion no implementada todavia. No se modifico GUI, empaquetado ni data | medio |
| 2026-05-09 | `feature/kx134-dual-capture` / TICKET 007 | `tools/platformio/pio.ps1`, `tools/platformio/pio.cmd`, `tools/platformio/kx134_single_node.ps1`, `tools/platformio/setup_platformio_user_path.ps1`, `tools/platformio/README.md`, `docs/kx134_migration/HARDWARE_WIRING_KX134_I2C.md`, `docs/kx134_migration/PLATFORMIO_WINDOWS_SETUP.md`, `docs/kx134_migration/tickets/TICKET_007_CABLEADO_PLATFORMIO_WINDOWS.md`, `firmware/kx134_single_node_i2c/README.md`, `docs/kx134_migration/TICKET_BACKLOG.md`, `reports/change_log.md` | alta/herramientas_documentacion | Documentacion de cableado KX134 I2C y creacion de wrappers PlatformIO Windows | Se documenta cableado 3V3/GND/SDA/SCL con SDA en GPIO21 y SCL en GPIO22. Se agregan wrappers para usar PlatformIO aunque `pio` no este en PATH y un script opcional para agregar PlatformIO al PATH de usuario. No se modifico `main.cpp`, no se subio firmware automaticamente, no se modifico GUI, empaquetado ni data | bajo |
| 2026-05-09 | `feature/kx134-dual-capture` / TICKET 007 hardware | `firmware/kx134_single_node_i2c/src/main.cpp`, `reports/kx134_test_runs/*` | correccion/validacion_firmware | Subir firmware KX134 single-node a ESP32 sensora 1, resolver silencio de diagnostico y validar salida Serial real | Se valida upload asistido por BOOT en COM5, KX134 detectado en I2C 0x1F, MAC `D4:E9:F4:E9:8E:1C`, stream CSV KX134 v3 a 921600 baudios con 1436 filas limpias, `seq` 0..1435 sin saltos, frecuencia efectiva 100 Hz, `g_norm` promedio 1.0258 y sin campos ADXL335 prohibidos. Se mejora el firmware para no quedar silencioso ante fallos de inicializacion y reportar probes I2C/reintentos. No se modifico GUI, empaquetado ni data historica | medio |
| 2026-05-09 | `feature/kx134-dual-capture` / TICKET 009 | `tools/kx134/calibrate_kx134_sensor.ps1`, `tools/kx134/README.md`, `config/calibrations/kx134_sensor_1.json`, `config/kx134_node_map.json`, `docs/kx134_migration/CALIBRATION_PROCEDURE_SENSOR1.md`, `docs/kx134_migration/tickets/TICKET_009_CALIBRACION_SENSOR1_KX134.md`, `docs/kx134_migration/TICKET_BACKLOG.md`, `reports/kx134_calibration/sensor_1/kx134_sensor1_cal_20260508_234831/*`, `reports/change_log.md` | alta/calibracion | Calibracion interactiva de seis posiciones para KX134 Sensor 1 | Se calibra Sensor 1 en COM5 a 921600 baudios, MAC `D4:E9:F4:E9:8E:1C`, sample_rate_hz 100, range_g 8. Las seis posiciones pasan sin advertencias, `seq_gaps_total=0`, `timestamp_errors_total=0` y `SENSOR_1_CALIBRATION_VALID=YES`. Se generan coeficientes y mapeo de nodo para uso futuro. No se modifico firmware, no se modifico GUI, no se modifico empaquetado, no se modifico data historica y no se aplico calibracion en firmware todavia | bajo |
| 2026-05-09 | `feature/kx134-dual-capture` / TICKET 010 | `firmware/kx134_single_node_i2c/platformio.ini`, `tools/platformio/kx134_single_node.ps1`, documentacion KX134, `config/kx134_node_map.json`, `reports/kx134_test_runs/TICKET_010_*`, `reports/change_log.md` | alta/validacion_firmware | Preparar entorno Sensor 2 y prueba fisica Serial KX134 | Se agregan entornos PlatformIO `kx134_sensor_1` y `kx134_sensor_2`; se valida build de ambos y upload Sensor 2 en COM5. Sensor 2 transmite `sensor_id=2`, MAC `D4:E9:F4:C3:37:14`, 100 Hz, range_g 8, 1902 filas limpias, `seq_gaps=0`, `timestamp_errors=0`, frecuencia efectiva 100.000 Hz y `READY_FOR_SENSOR_2_CALIBRATION=YES`. No se calibro Sensor 2, no se modifico GUI, no se modifico empaquetado, no se modifico data historica y no se aplico calibracion en firmware | bajo |
| 2026-05-09 | `feature/kx134-dual-capture` / TICKET 011 | `tools/kx134/calibrate_kx134_sensor.ps1`, `tools/kx134/README.md`, `config/calibrations/kx134_sensor_2.json`, `config/kx134_node_map.json`, `docs/kx134_migration/CALIBRATION_PROCEDURE*.md`, `docs/kx134_migration/tickets/TICKET_011_CALIBRACION_SENSOR2_KX134.md`, `reports/kx134_calibration/sensor_2/kx134_sensor2_cal_20260509_180839/*`, `reports/change_log.md` | alta/calibracion | Calibracion interactiva de seis posiciones para KX134 Sensor 2 | Se generaliza la herramienta de calibracion para Sensor 1/Sensor 2 y se calibra Sensor 2 en COM5 a 921600 baudios, MAC `D4:E9:F4:C3:37:14`, sample_rate_hz 100, odr_hz 100, range_g 8. Las seis posiciones pasan sin advertencias, `seq_gaps_total=0`, `timestamp_errors_total=0` y `SENSOR_2_CALIBRATION_VALID=YES`. Se generan coeficientes, capturas y reporte de calibracion Sensor 2. No se modifico firmware, no se modifico GUI, no se modifico empaquetado, no se modifico data historica, no se aplico calibracion en firmware y no se modifico la calibracion Sensor 1 | bajo |
| 2026-05-09 | `feature/kx134-dual-capture` / TICKET 012 | `firmware/kx134_receiver_identity/*`, `docs/kx134_migration/RECEIVER_IDENTITY_KX134.md`, `docs/kx134_migration/tickets/TICKET_012_CAPTURAR_MAC_RECEPTOR_KX134.md`, `config/kx134_node_map.json`, `reports/kx134_test_runs/TICKET_012_*`, `reports/change_log.md` | alta/validacion_firmware | Captura de MAC de ESP32 receptora KX134 | Se crea firmware minimo de identidad para la ESP32 receptora, se compila y se sube por COM4. La MAC capturada es `00:4B:12:96:9A:80`; `config/kx134_node_map.json` queda con `receiver_esp32` en estado `mac_captured_pending_kx134_receiver_firmware`. No se modifico firmware de sensores, no se modificaron calibraciones, no se modifico GUI, no se modifico empaquetado, no se modifico data historica y no se implemento ESP-NOW dual todavia | bajo |
| 2026-05-10 | `feature/kx134-dual-capture` / TICKET 013 | `firmware/kx134_dual_espnow/*`, `tools/kx134/analyze_dual_espnow_log.py`, `docs/kx134_migration/FIRMWARE_DUAL_ESPNOW_KX134.md`, `docs/kx134_migration/tickets/TICKET_013_FIRMWARE_ESPNOW_KX134_DUAL.md`, `config/kx134_node_map.json`, `reports/kx134_test_runs/TICKET_013_*`, `reports/change_log.md` | alta/firmware_validacion | Firmware dual ESP-NOW KX134 con dos nodos sensores hacia receptor Serial | Se crea firmware PlatformIO independiente `kx134_dual_espnow` con entornos Sensor 1, Sensor 2 y receptor. Sensor 1 MAC `D4:E9:F4:E9:8E:1C`, Sensor 2 MAC `D4:E9:F4:C3:37:14`, Receptor MAC `00:4B:12:96:9A:80`, `sample_rate_hz=100`, `odr_hz=100`, `range_g=8`, ESP-NOW channel 1 y calibraciones embebidas desde los JSON existentes. Los tres builds pasan, los tres uploads pasan y el receptor Serial emite KX134 v3 con ambos sensores. El analisis del log `TICKET_013_dual_espnow_receiver_monitor_20260510_104746.txt` genera `READY_FOR_DUAL_SYNC_PRECHECK=YES`, `seq_gaps=0`, frecuencia efectiva ~100 Hz por sensor, `invalid=0`, `queue_drops=0` y sin campos prohibidos ADXL335/mV/g_norm. No se modifico GUI, no se modifico empaquetado, no se modificaron calibraciones, no se modifico firmware ADXL335 y no se modifico data historica | medio |
| 2026-05-10 | `feature/kx134-dual-capture` / TICKET 014 | `tools/kx134/capture_serial_direct.ps1`, `tools/kx134/analyze_dual_sync_precheck.py`, `firmware/kx134_dual_espnow/src/main.cpp`, `firmware/kx134_dual_espnow/README.md`, `docs/kx134_migration/DUAL_SYNC_PRECHECK_KX134.md`, `docs/kx134_migration/tickets/TICKET_014_PRECHECK_SINCRONIZACION_DUAL_KX134.md`, `config/kx134_node_map.json`, `reports/kx134_test_runs/TICKET_014_*`, `docs/kx134_migration/TICKET_BACKLOG.md`, `reports/change_log.md` | alta/firmware_validacion | Precheck de sincronizacion dual KX134 y diagnostico de duplicados | Se captura Serial directo en COM4 para descartar artefactos de PlatformIO monitor. La captura inicial confirma `DUPLICATES_RECEIVER_STREAM_LIKELY` con 14 grupos `sensor_id+seq` repetidos con `receiver_t_us` y `pair_seq` diferentes; se aplica filtro acotado en el receptor por `sensor_id+node_mac+seq+sensor_t_us`, se recompilan los tres entornos y se sube de nuevo el receptor. La captura estatica final queda con 2999 filas por sensor, 100 Hz, `seq_gaps=0`, `invalid=0`, `queue_drops=0`, `duplicate_drops=27`, sin duplicados CSV y pairing p95 8.106 ms. La captura de evento final detecta evento comun en ambos sensores, delta `-12077 us` (`-12.077 ms`), pairing p95 7.970850 ms y sin duplicados CSV. Decision final `READY_FOR_GUI_KX134_STREAM_INTEGRATION=YES`. No se modificaron calibraciones, no se modifico firmware ADXL335, no se modifico GUI, no se modifico empaquetado y no se modifico data historica | medio |
| 2026-05-10 | `feature/kx134-dual-capture` / TICKET 015 | `gui/kx134_stream_contract.py`, `gui/kx134_live_core.py`, `gui/kx134_live_gui.py`, `tests/test_kx134_stream_parser.py`, `tests/test_kx134_capture_export.py`, `tools/kx134/replay_kx134_log_to_core.py`, `docs/kx134_migration/GUI_KX134_STREAM_INTEGRATION.md`, `docs/kx134_migration/tickets/TICKET_015_GUI_KX134_STREAM_INTEGRATION.md`, `reports/kx134_gui_validation/TICKET_015_*`, `docs/kx134_migration/TICKET_BACKLOG.md`, `reports/change_log.md` | alta/gui_core_validacion | Integracion de stream Serial KX134 v3 en GUI/core | Se agrega contrato Python KX134 v3, parser estricto de 27 campos, core de captura/exportacion KX134 separado, modulo GUI KX134 independiente, pruebas `unittest` y replay con log real de TICKET 014. El replay detecta ambos sensores, exporta CSV/JSON/resumen temporal y deja evidencia en `reports/kx134_gui_validation`. Firmware no modificado; calibraciones no modificadas; GUI ADXL335 historica preservada; empaquetado no modificado; data historica no modificada | bajo |
| 2026-05-10 | `feature/kx134-dual-capture` / TICKET 016 | `gui/kx134_live_core.py`, `tools/kx134/validate_gui_hardware_capture.py`, `docs/kx134_migration/GUI_KX134_HARDWARE_VALIDATION.md`, `docs/kx134_migration/tickets/TICKET_016_GUI_KX134_HARDWARE_VALIDATION.md`, `reports/kx134_gui_validation/TICKET_016_*`, `docs/kx134_migration/TICKET_BACKLOG.md`, `reports/change_log.md` | alta/gui_core_validacion | Validacion GUI KX134 con hardware real y exportacion de sesion | Se valida la GUI KX134 con receptor real en `COM4` a `921600`, duracion `10 s`, frecuencia esperada `100 Hz` y salida controlada en `reports/kx134_gui_validation/TICKET_016_hw_capture_20260510_124537/`. La captura final exporta CSV/JSON/summary con Sensor 1 `1001` filas, Sensor 2 `999` filas, frecuencias efectivas `100.0` y `100.00002004008418` Hz, `seq_gaps=0`, `invalid_lines=0`, `duplicate_keys=0`, `receiver_t_us` valido, `pc_wall_s` positivo, `packet_status=OK`, `packet_error_code=OK` y sin campos prohibidos. Se diagnostico que COM4 puede resetear el receptor y se aplico bugfix acotado al core KX134: warmup serial de 2 s, `time.perf_counter()` y mayor precision de `pc_wall_s`. Decision `READY_FOR_GUI_EXPORT_HARDENING=YES`. Firmware no modificado; calibraciones no modificadas; firmware ADXL335 no modificado; GUI ADXL335 preservada; empaquetado no modificado; data historica no modificada | bajo |
| 2026-05-10 | `feature/kx134-dual-capture` / TICKET 017 | `gui/kx134_live_core.py`, `gui/kx134_stream_contract.py`, `tools/kx134/validate_kx134_export_bundle.py`, `tests/test_kx134_export_metadata_schema.py`, `docs/kx134_migration/KX134_EXPORT_METADATA_HARDENING.md`, `docs/kx134_migration/tickets/TICKET_017_EXPORT_METADATA_HARDENING.md`, `config/kx134_node_map.json`, `reports/kx134_gui_validation/TICKET_017_*`, `docs/kx134_migration/TICKET_BACKLOG.md`, `reports/change_log.md` | alta/gui_core_validacion | Endurecimiento de exportacion KX134 y metadata | Se amplia la metadata de sesion KX134 con identidad de sesion, duraciones, arquitectura, nodos esperados, rutas relativas portables, resumen auditable y decision de validez. Se crea validador de bundle KX134, pruebas de esquema y un bundle endurecido generado desde la captura real TICKET 016. El bundle nuevo pasa con Sensor 1 `1001` filas, Sensor 2 `999` filas, frecuencias efectivas `100.0` y `100.00002004008418` Hz, `seq_gaps=0`, `invalid_lines=0`, `duplicate_keys=0`, `metadata_schema_pass=true`, `relative_artifacts_pass=true` y sin campos prohibidos. El bundle TICKET 016 queda documentado como metadata legacy sin modificar artefactos historicos. Decision `READY_FOR_GUI_VISUAL_REDESIGN=YES`. Firmware no modificado; calibraciones no modificadas; firmware ADXL335 no modificado; empaquetado no modificado; data historica no modificada; ADXL335 preservado | bajo |
| 2026-05-10 | `feature/kx134-dual-capture` / TICKET 018 | `gui/kx134_live_gui.py`, `gui/ui_theme.py`, `gui/ui_components.py`, `gui/app_launcher.py`, `tools/kx134/gui_smoke_test.py`, `tests/test_kx134_gui_smoke.py`, `tests/test_app_launcher_smoke.py`, `docs/kx134_migration/GUI_VISUAL_REDESIGN.md`, `docs/kx134_migration/tickets/TICKET_018_GUI_VISUAL_REDESIGN.md`, `config/kx134_node_map.json`, `reports/kx134_gui_validation/TICKET_018_*`, `docs/kx134_migration/TICKET_BACKLOG.md`, `reports/change_log.md` | alta/gui_visual_validacion | Rediseno visual profesional/responsive de GUI KX134 y launcher | Se crea launcher principal para KX134/ADXL335, tema visual compartido, componentes responsive y una GUI KX134 con tabs de conexion, captura, sensores, diagnostico y exportacion. La ventana KX134 queda en `1180x760`, minimo `980x640`, con scroll en secciones, rutas en entradas readonly y DPI awareness best effort. Se agrega smoke visual sin hardware, pruebas unitarias y reporte. Decision `READY_FOR_WINDOWS_PACKAGING_PREP=YES`. Firmware no modificado; calibraciones no modificadas; empaquetado no modificado; data historica no modificada; ADXL335 preservado | bajo |
| 2026-05-10 | `feature/kx134-dual-capture` / TICKET 019 | `gui/kx134_live_core.py`, `gui/kx134_live_gui.py`, `gui/kx134_live_plots.py`, `tools/kx134/gui_live_plot_smoke_test.py`, `tests/test_kx134_live_plot_buffer.py`, `tests/test_kx134_gui_live_plots_smoke.py`, `docs/kx134_migration/GUI_KX134_LIVE_PLOTS.md`, `docs/kx134_migration/tickets/TICKET_019_GUI_KX134_LIVE_PLOTS.md`, `config/kx134_node_map.json`, `reports/kx134_gui_validation/TICKET_019_*`, `docs/kx134_migration/TICKET_BACKLOG.md`, `reports/change_log.md` | alta/gui_visual_validacion | Incorporacion de graficas en vivo KX134 para retroalimentacion durante captura | Se agrega panel `Graficas` con Canvas/Tkinter para ejes `x_g/y_g/z_g` por sensor, comparacion visual `|g|` y comparacion de eje seleccionado. El core emite `sample_batch` y `capture_progress` durante captura sin alterar parser ni exportacion. Se corrige el adaptador de callback live detectado en prueba real y la repeticion manual con hardware fue satisfactoria: graficas visibles, Sensor 1/Sensor 2 con senal, taps observables y captura completada. Smoke sintetico y pruebas pasan; exportacion KX134 preservada sin `g_norm`, `mv_*` ni voltajes. Decision `READY_FOR_WINDOWS_PACKAGING_PREP=YES`. Firmware no modificado; calibraciones no modificadas; empaquetado no modificado; data historica no modificada; ADXL335 preservado | bajo |
| 2026-05-10 | `feature/kx134-dual-capture` / TICKET 020 | `sistema_captura_acelerometria.spec`, `build_windows_app.ps1`, `packaging/windows/*`, `gui/app_launcher.py`, `gui/adxl_live_gui.py`, `tools/kx134/validate_windows_package.py`, `tests/test_app_launcher_frozen_routing.py`, `docs/kx134_migration/WINDOWS_PACKAGING_KX134.md`, `docs/kx134_migration/tickets/TICKET_020_WINDOWS_PACKAGING.md`, `config/kx134_node_map.json`, `reports/kx134_gui_validation/TICKET_020_*`, `.gitignore`, `docs/kx134_migration/TICKET_BACKLOG.md`, `reports/change_log.md` | alta/empaquetado_windows | Empaquetado Windows profesional para Sistema de Captura de Acelerometria | Se crea spec PyInstaller onedir con entrypoint `gui/app_launcher.py`, build script `build_windows_app.ps1`, manifest DPI-aware, validador de paquete y documentacion. El launcher queda frozen-aware con `--mode launcher/kx134/adxl` y smoke; ADXL335 recibe solo wrappers de import/smoke sin cambiar parser/exportacion. Build local ejecutado con venv local, smoke launcher y KX134 pasan, smoke ADXL pasa, y validador confirma `exe_exists=true`, `zip_exists=true`, configs KX134 incluidas, `historical_data_packaged=false` y `validation_pass=true`. Decision `READY_FOR_EXTERNAL_PC_QA=YES`. Firmware no modificado; calibraciones no modificadas; data historica no modificada; ADXL335 preservado; `dist/`, `build_work/`, `.venv`, `.exe` y `.zip` no commiteados | bajo |
| 2026-05-10 | `feature/kx134-dual-capture` / TICKET 021 | `tools/kx134/external_pc_qa.ps1`, `tools/kx134/external_pc_qa_check.py`, `docs/kx134_migration/EXTERNAL_PC_QA_CHECKLIST.md`, `docs/kx134_migration/tickets/TICKET_021_EXTERNAL_PC_QA.md`, `reports/kx134_gui_validation/TICKET_021_*`, `docs/kx134_migration/TICKET_BACKLOG.md`, `reports/change_log.md` | documentacion/qa_pendiente | Preparacion de QA externo del ejecutable Windows | Se crean checklist, script PowerShell y validador Python para ejecutar QA del paquete `Sistema_Captura_Acelerometria` en otro PC. CODEX se ejecuto en el PC de desarrollo, por lo que se hizo solo una corrida de referencia local contra `dist\Sistema_Captura_Acelerometria`: smoke launcher, KX134 y ADXL pasan en Windows 10.0.26200, 1920x1080, scaling 100%. No se ejecuta QA real en PC externo ni captura hardware externa; decision `READY_FOR_CLIENT_PROTOTYPE_QA=PENDING`. Firmware no modificado; calibraciones no modificadas; data historica no modificada; `dist/`, `build_work/`, `.venv`, `.exe` y `.zip` no commiteados; ADXL335 preservado | bajo |
| 2026-05-10 | `feature/kx134-dual-capture` / TICKET 021B | `reports/kx134_gui_validation/TICKET_021_EXTERNAL_PC_QA_SUMMARY.md`, `reports/kx134_gui_validation/TICKET_021_external_pc_qa_output.json`, `config/kx134_node_map.json`, `docs/kx134_migration/TICKET_BACKLOG.md`, `docs/kx134_migration/tickets/TICKET_021B_CIERRE_QA_EXTERNO_MANUAL.md`, `reports/change_log.md` | documentacion/cierre_qa | Cierre formal de QA externo visual/manual del ejecutable Windows | Se incorpora el reporte manual del usuario en PC externo `MOMOTTO_PC`: smoke launcher/KX134/ADXL PASS, Windows 11 Home Single Language 10.0.26200 build 26200 64 bits, resolucion 1920x1080, scaling 100%, launcher visible, KX134 visible, ADXL visible y sin cortes visuales relevantes reportados. La captura hardware externa no se ejecuto y queda como advertencia no bloqueante porque la captura hardware real ya fue validada previamente en el PC de desarrollo. Decision `READY_FOR_CLIENT_PROTOTYPE_QA=YES`. Firmware no modificado; calibraciones no modificadas; GUI no modificada; empaquetado no modificado; data historica no modificada; `dist/`, `.exe` y `.zip` no commiteados | bajo |
| 2026-05-10 | `feature/kx134-dual-capture` / TICKET 022 | `tools/kx134/validate_prototype_session.py`, `docs/kx134_migration/PROTOTYPE_VALIDATION_PLAN.md`, `docs/kx134_migration/PCB_BAQUELADA_CRITERIA.md`, `docs/kx134_migration/tickets/TICKET_022_PROTOTYPE_VALIDATION_AND_PCB_CRITERIA.md`, `reports/prototype_validation/TICKET_022_*`, `config/kx134_node_map.json`, `docs/kx134_migration/TICKET_BACKLOG.md`, `reports/change_log.md` | validacion_prototipo | Validacion de prototipo con sesion controlada y criterios para baquelada | Se ejecuta sesion controlada KX134 de `60 s` en `COM4` a `921600`, frecuencia esperada `100 Hz`, rango `8 g`, salida controlada en `reports/prototype_validation/TICKET_022_controlled_session_20260510_162258/`. La captura final exporta CSV/JSON/summary con Sensor 1 `5998` filas, Sensor 2 `6000` filas, frecuencias efectivas `99.966656` y `100.000007` Hz, `seq_gaps` Sensor 1 `2` como advertencia, Sensor 2 `0`, `invalid_lines=0`, `duplicate_keys=0`, `pc_wall_s` positivo, `receiver_t_us` valido, `packet_status=OK`, `packet_error_code=OK` y sin campos prohibidos. `validate_prototype_session.py` y `validate_kx134_export_bundle.py` pasan; `READY_FOR_PROTOTYPE_DELIVERY=YES` y `READY_FOR_PCB_DESIGN=NO` por decisiones fisicas/mecanicas pendientes. Firmware no modificado; GUI no modificada; calibraciones no modificadas; empaquetado no modificado; data historica no modificada; `dist/`, `.exe` y `.zip` no commiteados | bajo |
| 2026-05-10 | `feature/kx134-dual-capture` / TICKET 023 | `docs/kx134_migration/PROTOTYPE_DELIVERY_PACKAGE.md`, `docs/kx134_migration/TECHNICAL_STATUS_SUMMARY.md`, `docs/kx134_migration/VALIDATION_EVIDENCE_MATRIX.md`, `docs/kx134_migration/OPEN_ITEMS_AND_RISKS.md`, `docs/kx134_migration/tickets/TICKET_023_PROTOTYPE_DELIVERY_PACKAGE.md`, `tools/kx134/build_delivery_readiness_report.py`, `tools/kx134/validate_prototype_session.py`, `config/kx134_node_map.json`, `reports/prototype_validation/TICKET_023_*`, `docs/kx134_migration/TICKET_BACKLOG.md`, `reports/change_log.md` | documentacion_entrega | Consolidacion de entrega tecnica del prototipo KX134 dual | Se crea paquete documental de entrega, resumen tecnico, matriz de evidencias y registro de pendientes/riesgos. Se corrige la semantica del validador para separar recomendacion tecnica de captura y autorizacion final PCB, y se genera `TICKET_023_pcb_readiness_correction.json` sin modificar el artefacto historico TICKET 022. Decision `PROTOTYPE_DELIVERY_PACKAGE_READY=YES` y `PCB_DESIGN_AUTHORIZED=NO` por blockers fisicos/mecanicos. Firmware no modificado; GUI no modificada; calibraciones no modificadas; empaquetado no modificado; data historica no modificada; `dist/`, `.exe` y `.zip` no commiteados | bajo |
| 2026-05-10 | `feature/kx134-dual-capture` / TICKET 024 | `docs/kx134_migration/client/*`, `docs/kx134_migration/tickets/TICKET_024_CLIENT_USER_DOCUMENTATION.md`, `tools/kx134/validate_client_docs.py`, `config/kx134_node_map.json`, `reports/prototype_validation/TICKET_024_*`, `docs/kx134_migration/TICKET_BACKLOG.md`, `reports/change_log.md` | documentacion_cliente | Documentacion de usuario/cliente para prototipo KX134 | Se crea guia rapida, manual de usuario, instalacion Windows, conexion hardware, captura/exportacion, referencia de archivos, troubleshooting, release notes, manifiesto de entrega, checklists pre/post prueba y limitaciones. Se agrega validador documental para confirmar terminos clave, ausencia de contradiccion PCB y advertencias sobre `sample_rate_hz`, `range_g` y recalibracion. Decision `CLIENT_USER_DOCS_READY=YES`; `PCB_DESIGN_AUTHORIZED=NO`. Firmware no modificado; GUI no modificada; calibraciones no modificadas; empaquetado no modificado; data historica no modificada; `dist/`, `.exe` y `.zip` no commiteados | bajo |
| 2026-05-10 | `feature/kx134-dual-capture` / TICKET 025 | `docs/kx134_migration/pcb/*`, `docs/kx134_migration/tickets/TICKET_025_PCB_PHYSICAL_DEFINITION.md`, `config/kx134_physical_design_decisions.json`, `tools/kx134/validate_pcb_physical_decisions.py`, `config/kx134_node_map.json`, `reports/prototype_validation/TICKET_025_*`, `docs/kx134_migration/TICKET_BACKLOG.md`, `reports/change_log.md` | documentacion_pcb | Definicion fisica para PCB/baquelada | Se crea formulario de decisiones fisicas, especificacion preliminar, matriz, checklist de riesgos, pre-design review, JSON documental y validador. No se recibieron decisiones cerradas del usuario para alimentacion, conectores, cableado, montaje, orientacion, receptor, ambiente o restricciones de cliente, por lo que se registran blockers criticos y la decision queda `PCB_PHYSICAL_DECISIONS_COMPLETE=NO`, `PCB_DESIGN_AUTHORIZED=NO`. Firmware no modificado; GUI no modificada; calibraciones no modificadas; empaquetado no modificado; data historica no modificada; no se generaron archivos PCB, Gerber ni BOM | bajo |
| 2026-05-10 | `feature/kx134-dual-capture` / TICKET 026 | `hardware/pcb/baquelada_revA/*`, `config/kx134_baquelada_revA_review.json`, `tools/kx134/validate_baquelada_reva.py`, `config/kx134_physical_design_decisions.json`, `config/kx134_node_map.json`, `reports/prototype_validation/TICKET_026_*`, `docs/kx134_migration/tickets/TICKET_026_BAQUELADA_REVA_REVIEW.md`, `docs/kx134_migration/TICKET_BACKLOG.md`, `reports/change_log.md` | documentacion_pcb_revision | Registro y revision de baquelada/PCB RevA creada en Proteus | Se registran artefactos `Maestria.PDF` y `Maestria.SVG` bajo `hardware/pcb/baquelada_revA/artifacts/`, se detectan dimensiones SVG `90.49 mm x 44.99 mm`, se documenta revision visual `PASS_WITH_WARNINGS`, checklist de continuidad, pinout pendiente, plan de pruebas y validador documental. El usuario confirma que la RevA es para nodos sensores KX134, repetida para Sensor 1/Sensor 2; el receptor no lleva baquela y queda directo al PC. La baquelada RevA queda `under_review`, no aceptada aun para uso de prototipo y `PCB_DESIGN_AUTHORIZED=NO`. Firmware no modificado; GUI no modificada; calibraciones no modificadas; empaquetado no modificado; data historica no modificada; no se generaron Gerbers; PCB final no autorizada | bajo |
| 2026-05-10 | `feature/kx134-dual-capture` / TICKET 027 | `README.md`, `AGENTS.md`, `docs/README.md`, `docs/assets/*`, `docs/kx134_migration/INDEX.md`, `docs/kx134_migration/REPOSITORY_STATUS.md`, `docs/kx134_migration/ARCHITECTURE_OVERVIEW.md`, `docs/kx134_migration/OPERATIONS_OVERVIEW.md`, `docs/kx134_migration/DEVELOPMENT_GUIDE.md`, `docs/kx134_migration/VALIDATION_SUMMARY.md`, `docs/kx134_migration/LEGACY_ADXL335_NOTES.md`, `docs/kx134_migration/REPOSITORY_MAINTENANCE.md`, `tools/kx134/validate_repository_readiness.py`, `tools/kx134/capture_gui_screenshots.ps1`, `reports/repository_health/TICKET_027_*`, `config/kx134_node_map.json`, `docs/kx134_migration/TICKET_BACKLOG.md`, `reports/change_log.md` | documentacion_readiness | Limpieza y profesionalizacion integral del repositorio KX134 | Se reescriben README y AGENTS para presentar KX134 dual como flujo principal, ADXL335 como legacy, ejecutable Windows actual, validaciones, baquelada RevA bajo revision y PCB no autorizada. Se agregan indices, diagramas Mermaid, guia de mantenimiento, validador de readiness y script guiado de screenshots. Decision `REPOSITORY_PRODUCTION_READY=YES_WITH_SCREENSHOTS_PENDING`; firmware no modificado; GUI funcional no modificada; calibraciones no modificadas; empaquetado funcional no modificado; data historica no modificada; binarios no commiteados; ADXL preservado como legacy; PCB no autorizada | bajo |
| 2026-05-11 | `feature/kx134-dual-capture` / TICKET 028 | `README.md`, `AGENTS.md`, `docs/kx134_migration/*`, `docs/kx134_migration/client/*`, `hardware/pcb/baquelada_revA/*`, `config/kx134_node_map.json`, `config/kx134_baquelada_revA_review.json`, `config/kx134_physical_design_decisions.json`, `config/kx134_project_final_status.json`, `tools/kx134/validate_final_project_state.py`, `reports/final_release/TICKET_028_*`, `reports/change_log.md` | documentacion_cierre_final | Cierre final del proyecto KX134 con baquelada RevA funcional validada por experto | Se actualiza el estado final: `PROJECT_FUNCTIONAL_COMPLETE=YES`, `PROTOTYPE_RELEASE_CANDIDATE_READY=YES`, `BAQUELADA_REVA_FUNCTIONAL_VALIDATED_BY_EXPERT=YES`, `BAQUELADA_REVA_ACCEPTED_FOR_PROTOTYPE_USE=YES` y `PRODUCTION_MANUFACTURING_PACKAGE_READY=NO`. La RevA queda aceptada para uso de prototipo Sensor 1/Sensor 2; produccion industrial repetible requiere DFM/BOM/Gerbers/QA si se solicita. Firmware no modificado; GUI funcional no modificada; calibraciones no modificadas; empaquetado funcional no modificado; data historica no modificada; `dist/`, `.exe` y `.zip` no commiteados; ADXL335 preservado como legacy | bajo |
| 2026-05-11 | `feature/kx134-dual-capture` / TICKET 029 | `docs/kx134_migration/client/*`, `docs/kx134_migration/TICKET_BACKLOG.md`, `config/kx134_node_map.json`, `tools/kx134/validate_final_project_state.py`, `reports/final_release/TICKET_029_*`, `reports/change_log.md` | documentacion_limpieza_final | Limpieza final de referencias obsoletas tras cierre funcional del proyecto | Se corrigen documentos cliente y backlog para eliminar referencias vigentes a estados anteriores como PCB no autorizada, baquelada no aceptada o decisiones fisicas pendientes. El validador final separa referencias `blocking`, `warning` e `historical_allowed`; la salida TICKET 029 pasa sin fallos ni warnings bloqueantes. Decision `DOCUMENTATION_STALE_REFERENCES_CLEAN=YES` y `REPOSITORY_FINAL_STATE_READY=YES`. Firmware no modificado; GUI no modificada; calibraciones no modificadas; empaquetado no modificado; data historica no modificada; binarios no commiteados | bajo |

| 2026-11-07 | `feature/kx134-dual-capture` / mantenimiento documental autorizado | `README.md`, `reports/change_log.md` | indice_documental | Enlace al informe IEEE P40 y su fuente LaTeX | Estado funcional y aceptación experta conservados; producción industrial pendiente de paquete DFM/BOM/Gerbers/QA. Firmware, GUI, calibración, datos y binarios sin cambios | bajo |
