hujjika1099-glitch/Repo/docs/kx134_migration/client/RELEASE_NOTES_PROTOTYPE.md

# Release notes - Prototype release KX134 dual

## Estado

El prototipo KX134 dual esta listo para entrega funcional.

- `PROTOTYPE_DELIVERY_PACKAGE_READY = YES`.
- `CLIENT_USER_DOCS_READY = YES` cuando esta documentacion pase validacion.
- `PROTOTYPE_RELEASE_CANDIDATE_READY = YES`; `PRODUCTION_MANUFACTURING_PACKAGE_READY = NO`.

## Incluye

- Firmware dual ESP-NOW KX134.
- Sensor 1 y Sensor 2 calibrados.
- Receptor ESP-NOW a USB Serial.
- GUI KX134 con graficas live.
- Exportacion CSV/JSON/summary endurecida.
- Ejecutable Windows onedir.
- Launcher para KX134 y ADXL335 historico.

## Validaciones completadas

- Calibracion Sensor 1.
- Calibracion Sensor 2.
- Dual ESP-NOW.
- Sync precheck.
- GUI hardware capture.
- Export hardening.
- Live plots.
- Packaging Windows.
- QA visual externa.
- Sesion controlada de prototipo.

## Configuracion validada

- `sample_rate_hz`: `100 Hz`.
- `odr_hz`: 100.
- `range_g`: `8 g`.
- Baudrate: `921600`.
- ESP-NOW channel: 1.

## Advertencias

- Sensor 1 tuvo 2 `seq_gaps` en la sesion controlada de 60 s; advertencia no bloqueante.
- RevA funcional aceptada para prototipo; produccion industrial repetible requiere DFM/BOM/Gerbers/QA si se solicita.
- Icono corporativo pendiente.
- Firma digital pendiente.
- Scaling Windows 125/150 pendiente.
- `sample_rate_hz` desde GUI a firmware pendiente.
- Hardware externo con captura queda pendiente si el cliente lo exige.

## Compatibilidad

El flujo ADXL335 historico se conserva. La documentacion de este paquete se enfoca en KX134.

## Cierre Final TICKET 028

- `PROJECT_FUNCTIONAL_COMPLETE = YES`
- `PROTOTYPE_RELEASE_CANDIDATE_READY = YES`
- `BAQUELADA_REVA_FUNCTIONAL_VALIDATED_BY_EXPERT = YES`
- `BAQUELADA_REVA_ACCEPTED_FOR_PROTOTYPE_USE = YES`
- `PRODUCTION_MANUFACTURING_PACKAGE_READY = NO`

La baquelada RevA fue completada fisicamente y validada como funcional por el experto del proyecto. Queda aceptada para uso de prototipo KX134 Sensor 1/Sensor 2. Esto no constituye paquete de fabricacion industrial repetible; si el cliente lo requiere, faltan DFM, BOM final, Gerbers y QA de manufactura.
