hujjika1099-glitch/Repo/hardware/pcb/baquelada_revA/artifacts/Maestria.PDF

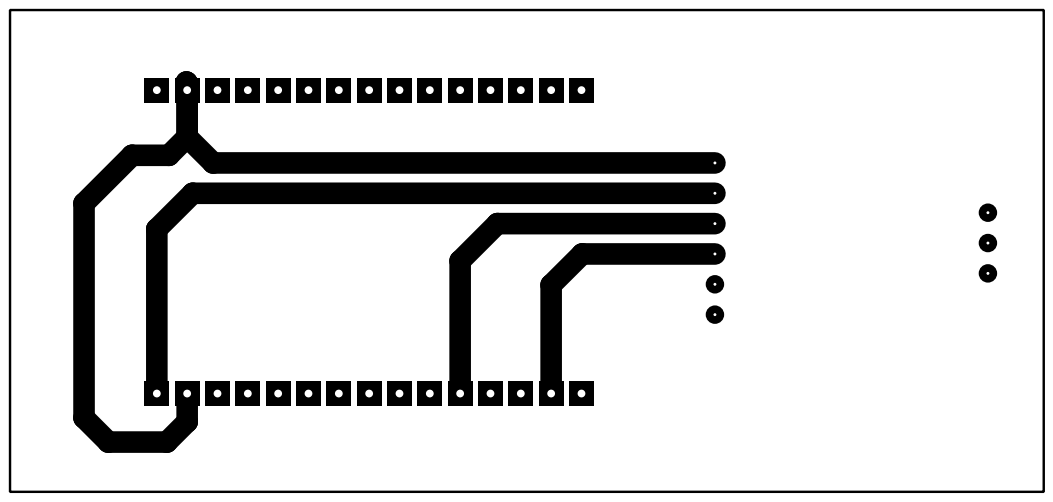
[picture p3: page 1]
