hujjika1099-glitch/Repo/(commit log)

2026-03-20 Agrega exclusion de entorno virtual local
2026-03-20 chore: bootstrap ADXL335 validation repository
    [sensor_registry.csv]
2026-03-20 feat: add single sensor acquisition firmware baseline
2026-03-20 feat: add baseline MATLAB capture workflow for single sensor
    [sensor_A_z_plus_static_20260320_132709.csv]
2026-03-20 feat: add single capture baseline analysis workflow
    [sensor_A_z_plus_static_repeatability_20260320_134904.csv, sensor_A_z_plus_static_repeatability_20260320_135043.csv]
2026-03-20 feat: add repeatability assessment workflow for single sensor baseline
    [sensor_A_z_plus_static_20260320_135921.csv, sensor_A_z_plus_static_20260320_140052.csv, sensor_A_z_plus_static_repeatability_20260320_140207.csv]
2026-03-20 feat: add controlled repeatability retest for single sensor baseline
    [sensor_A_z_plus_static_20260320_141206.csv, sensor_A_z_plus_static_20260320_165156.csv, sensor_A_z_plus_static_20260320_165401.csv, sensor_A_z_plus_static_repeatability_20260320_165502.csv]
2026-03-21 feat: add three-sensor same-pose screening workflow
    [sensor_A_z_plus_static_20260320_171159.csv, sensor_A_z_plus_static_20260320_171348.csv, sensor_A_z_plus_static_20260320_171521.csv, sensor_A_z_plus_static_20260320_171654.csv, sensor_A_z_plus_static_20260320_171823.csv, sensor_A_z_plus_static_repeatability_20260321_094627.csv, sensor_B_z_plus_static_20260320_180404.csv, sensor_B_z_plus_static_20260320_180533.csv]
2026-03-21 feat: add sensor_C six-pose static validation workflow
    [sensor_C_multipose_static_20260321_120320_pairs.csv, sensor_C_multipose_static_20260321_120320_poses.csv, sensor_C_multipose_static_20260321_120320_runs.csv, sensor_C_neg_x_20260321_104116.csv, sensor_C_neg_x_20260321_104255.csv, sensor_C_neg_x_20260321_104434.csv, sensor_C_neg_x_repeatability_20260321_115744.csv, sensor_C_neg_y_20260321_110157.csv]
2026-03-21 feat: add focused z-pair retest workflow for sensor_C
    [sensor_C_neg_z_20260321_124530.csv, sensor_C_neg_z_20260321_124710.csv, sensor_C_neg_z_20260321_124856.csv, sensor_C_neg_z_20260321_125038.csv, sensor_C_neg_z_20260321_125210.csv, sensor_C_neg_z_repeatability_20260321_125459.csv, sensor_C_pos_z_20260321_121702.csv, sensor_C_pos_z_20260321_121858.csv]
2026-03-21 feat: add definitive z-pair validation workflow for sensor_C
    [sensor_C_neg_z_20260321_132804.csv, sensor_C_neg_z_20260321_132949.csv, sensor_C_neg_z_20260321_133129.csv, sensor_C_neg_z_20260321_133305.csv, sensor_C_neg_z_20260321_133454.csv, sensor_C_neg_z_repeatability_20260321_133740.csv, sensor_C_pos_z_20260321_131713.csv, sensor_C_pos_z_20260321_131840.csv]
2026-03-21 feat: add final static calibration workflow for sensor_C
    [sensor_C_static_calibration_20260321_140044.csv, sensor_C_static_calibration_20260321_140044_dataset.csv, sensor_C_static_calibration_20260321_140044_poses.csv, sensor_C_static_calibration_20260321_140044_runs.csv, sensor_C_static_validation_20260321_140524.csv, sensor_C_static_validation_20260321_140524_poses.csv, sensor_registry.csv]
2026-03-21 feat: add refined affine 3x3 static calibration workflow for sensor_C
    [sensor_C_static_affine_3x3_20260321_142515.csv, sensor_C_static_affine_3x3_20260321_142515_dataset.csv, sensor_C_static_affine_3x3_20260321_142515_runs.csv, sensor_C_static_affine_3x3_validation_20260321_142847.csv, sensor_C_static_affine_3x3_validation_20260321_142847_comparison_vs_simple.csv, sensor_C_static_affine_3x3_validation_20260321_142847_poses.csv, sensor_registry.csv]
2026-03-21 feat: add focused neg_y and pos_z recalibration workflow for sensor_C
    [sensor_C_neg_y_20260321_144910.csv, sensor_C_neg_y_20260321_145114.csv, sensor_C_neg_y_20260321_145304.csv, sensor_C_neg_y_20260321_145514.csv, sensor_C_neg_y_20260321_145742.csv, sensor_C_pos_z_20260321_150204.csv, sensor_C_pos_z_20260321_150522.csv, sensor_C_pos_z_20260321_150752.csv]
2026-03-22 feat: add axis convention diagnosis workflow for sensor_C
    [sensor_C_axis_convention_dataset_phase103.csv, sensor_C_axis_convention_diagnosis_20260322_105051_axis_pairs.csv, sensor_C_axis_convention_diagnosis_20260322_105051_inference.csv, sensor_C_axis_convention_diagnosis_20260322_105051_poses.csv, sensor_C_axis_convention_diagnosis_20260322_105051_runs.csv, sensor_C_neg_x_20260322_101532.csv, sensor_C_neg_x_20260322_101703.csv, sensor_C_neg_x_20260322_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]
2026-03-22 feat: add reinforced axis convention diagnosis workflow for sensor_C
    [sensor_C_axis_convention_dataset_phase104.csv, sensor_C_axis_convention_phase104_20260322_115411_mapping.csv, sensor_C_axis_convention_phase104_20260322_115411_pairs.csv, sensor_C_axis_convention_phase104_20260322_115411_poses.csv, sensor_C_axis_convention_phase104_20260322_115411_runs.csv, sensor_C_neg_x_20260322_112213.csv, sensor_C_neg_x_20260322_112342.csv, sensor_C_neg_x_20260322_112521.csv]
2026-03-22 feat: add exhaustive axis mapping hypothesis search workflow for sensor_C
    [sensor_C_axis_mapping_search_20260322_122519_best_poses.csv, sensor_C_axis_mapping_search_20260322_122519_best_runs.csv, sensor_C_axis_mapping_search_20260322_122519_hypotheses.csv, sensor_C_axis_mapping_search_20260322_122519_top10.csv, sensor_C_axis_mapping_search_dataset_20260322_121904.csv, sensor_registry.csv]
2026-03-22 feat: add physical axis mapping disambiguation workflow for sensor_C
    [sensor_C_axis_mapping_disambiguation_20260322_130308_best_pairs.csv, sensor_C_axis_mapping_disambiguation_20260322_130308_best_poses.csv, sensor_C_axis_mapping_disambiguation_20260322_130308_families.csv, sensor_C_axis_mapping_disambiguation_20260322_130308_hypotheses.csv, sensor_C_axis_mapping_disambiguation_20260322_130308_top10.csv, sensor_C_axis_mapping_disambiguation_dataset_20260322_125115.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]
2026-03-22 feat: add coupled linear interpretation workflow for sensor_C
    [sensor_C_coupled_linear_model_20260322_131829.csv, sensor_C_coupled_linear_model_20260322_131829_poses.csv, sensor_C_coupled_linear_model_20260322_131829_runs.csv, sensor_C_coupled_linear_validation_20260322_132133.csv, sensor_C_coupled_linear_validation_20260322_132133_comparison_vs_simple.csv, sensor_C_coupled_linear_validation_20260322_132133_pairs.csv, sensor_C_coupled_linear_validation_20260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]
2026-03-22 feat: add regularized coupled interpretation workflow for sensor_C
    [sensor_C_coupled_regularized_candidates_20260322_135412.csv, sensor_C_coupled_regularized_model_20260322_135643.csv, sensor_C_coupled_regularized_selection_20260322_135643.csv, sensor_C_coupled_regularized_validation_20260322_135643.csv, sensor_C_coupled_regularized_validation_20260322_135643_comparison_vs_current_coupled.csv, sensor_C_coupled_regularized_validation_20260322_135643_comparison_vs_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]
2026-03-23 feat(live): single-matlab interactive session hub for sensor_B
2026-04-13 feat: Phase 15.5-15.6 — exe packaging, user manual and full repo update
    - adxl_captura.spec + build_exe.ps1: PyInstaller build system that
    produces a standalone ADXL335_Captura.exe (10 MB) and a distributable
    ZIP; no Python required on target machine
    - gui/adxl_live_gui.py: _resolve_repo_root() detects sys.frozen so
    data is saved next to the .exe in distribution mode
    - build_manual_pdf.py + ADXL335_Captura_Manual.pdf: 65-page user manual
    generated with fpdf2; covers all GUI controls, session flow, filename
    anatomy and complete field-by-field reference for every exported file
    - .gitignore: excludes dist/ and build_work/ (PyInstaller artifacts)
    - AGENTS.md: full rewrite as Claude g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
    [SensorB_Prueba_live2_20260322_213556_processed.csv, SensorB_Prueba_live3_20260322_214721_processed.csv, module_registry_fast_bringup.csv, probe2_live_20260331_111438_processed.csv, probe4_live_20260331_111716_processed.csv, probe7_live_20260331_114920_processed.csv, sensor_B_live_Prueba1_live_20260322_211749_processed.csv, sensor_B_live_live_20260331_100952_processed.csv]
2026-05-08 chore: preserve ADXL335 local state and sync audit
    [SensorB_Prueba_live2_20260322_213556_raw.csv, SensorB_Prueba_live3_20260322_214721_raw.csv, probe2_live_20260331_111438_raw.csv, probe4_live_20260331_111716_raw.csv, probe7_live_20260331_114920_raw.csv, sensor_A_phase12_quickcheck_20260322_185043_axes.csv, sensor_A_quickcheck_static_20260322_184959.csv, sensor_B_live_Prueba1_live_20260322_211749_raw.csv]
2026-05-08 docs: audit current repo for KX134 migration
2026-05-08 docs: confirm KX134 three-ESP32 architecture
2026-05-09 docs: update KX134 ODR options to 100 200 400 800 Hz
2026-05-09 firmware: add KX134 single-node I2C prototype
2026-05-09 tools: add PlatformIO Windows helpers and KX134 wiring docs
2026-05-09 firmware: validate KX134 sensor 1 serial bring-up
2026-05-09 calibration: add KX134 sensor 1 six-position calibration
    [X_NEG.csv, Y_NEG.csv, Z_NEG.csv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]
2026-05-09 firmware: validate KX134 sensor 2 serial bring-up
2026-05-09 calibration: add KX134 sensor 2 six-position calibration
    [X_NEG.csv, Y_NEG.csv, Z_NEG.csv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]
2026-05-10 firmware: capture KX134 receiver ESP32 MAC
2026-05-10 firmware: add KX134 dual ESP-NOW prototype
2026-05-10 test: validate KX134 GUI hardware capture
    [kx134_dual_live_ticket016_hw_gui_20260510_123340_raw.csv, kx134_dual_live_ticket016_hw_gui_20260510_123921_raw.csv, kx134_dual_live_ticket016_hw_gui_20260510_124204_raw.csv, kx134_dual_live_ticket016_hw_gui_20260510_124423_raw.csv, kx134_dual_live_ticket016_hw_gui_20260510_124627_raw.csv]
2026-05-10 gui: harden KX134 export metadata
    [kx134_dual_live_ticket017_export_hardening_20260510_130507_raw.csv]
2026-05-10 gui: redesign KX134 interface for responsive layout
    [app_launcher.py, gui_smoke_test.py, kx134_live_gui.py, ui_components.py, ui_theme.py]
2026-05-10 test: validate KX134 prototype controlled session
    [kx134_dual_live_ticket022_prototype_controlled_20260510_162412_raw.csv]
2026-05-10 docs: consolidate KX134 prototype delivery package
2026-05-10 docs: define KX134 PCB physical design decisions
2026-05-10 docs: clarify KX134 baquelada RevA sensor role
